depalamarchuk/GaNFET-ESC/README.md

# GaNFET-ESC
This is my master project. Work in progress.
