depalamarchuk/GaNFET-ESC/Thesis/Very Important App Notes/PRIVATE-Myxadesignnotes-241019-1215-2464 (2).pdf

# Myxa design notes

Phase signal sensing

This document describes main decisions when designing Myxa PMSM controller.

Sections:

MCU
Step-down converter
DRV8302
Power mosfets
Phase current sensing
Phase signal sensing
Input capacitor battery
UAVCAN
USB
AUX input
TVS diode

# MCU

MYXA uses STM32F446 MCU, preferably with operating temperature range -40..+105C. Current boards though have only -40°C ~ 85°C MCU version. This is known issue and a least-evil solution due to the lack of proper MCUs in the world.

MCU is powered by dedicated 3.3V LDO. (https://www.digikey.com/product-detail/en/texas-instruments/TPS73433TDDCRQ1/296-36844-1-ND/4341509)

VDDA is tied to reference voltage source REF3033. (https://www.digikey.com/products/en?keywords=296-26324-1-ND) It may seem weird, but it is capable of providing up to 25mA current, so its ok.

# Step-down converter

Step-down dc-dc converter is tps54160 (https://www.digikey.com/product-detail/en/texas-instruments/TPS54160DGQR/296-26984-2-ND/2047950) embedded in DRV8302 (https://www.digikey.com/product-detail/en/texas-instruments/DRV8302DCA/296-33275-5-ND/2799356)

Inductor SRP6540-220M (https://www.digikey.com/products/en?keywords=SRP6540-220MTR-ND) (FIXED IND 22UH 2.5A 133 MOHM SMD)

Shottky diode: PMEG6020ER,115 (https://www.digikey.com/product-detail/en/nexperia-usa-inc/PMEG6020ER,115/1727-5217-2-ND/2296182) (DIODE SCHOTTKY 60V 2A SOD123W)

Input:

Vin = 8..60V

## Output:

R1 = 10K, R2 = 53,6K

## Operating frequency:

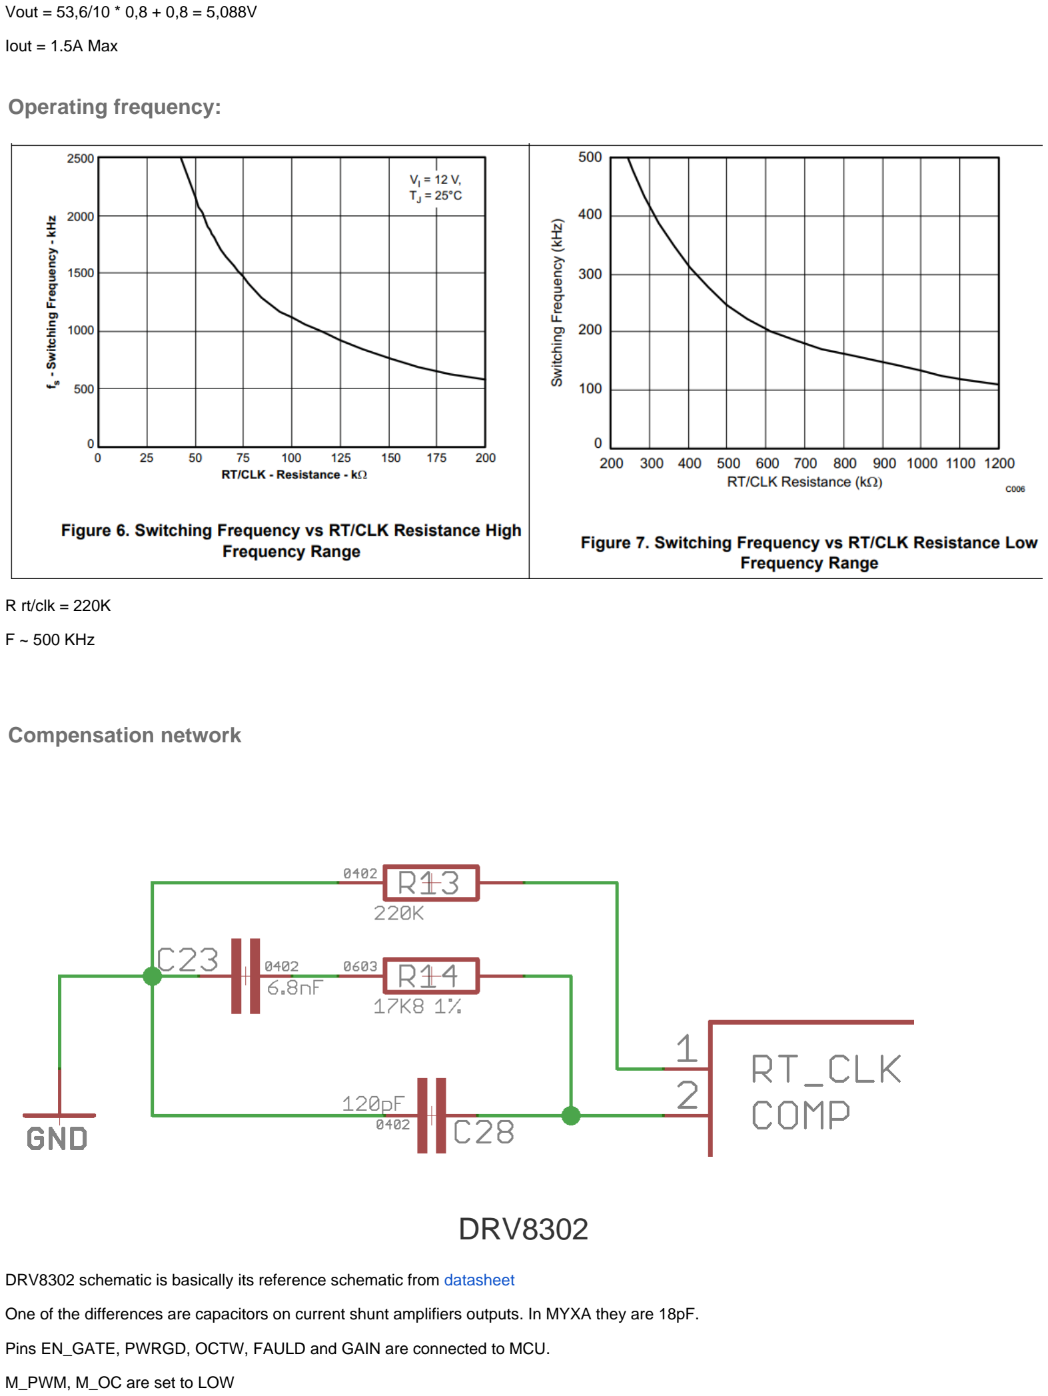
[picture p1: page 2]

Vout = 53,6/10 * 0,8 + 0,8 = 5,088V

Iout = 1.5A Max

R rt/clk = 220K

F ~ 500 KHz

## Compensation network

# DRV8302

DRV8302 schematic is basically its reference schematic from datasheet (http://www.ti.com/lit/ds/symlink/drv8302.pdf)

One of the differences are capacitors on current shunt amplifiers outputs. In MYXA they are 18pF.

Pins EN_GATE, PWRGD, OCTW, FAULD and GAIN are connected to MCU.

M_PWM, M_OC are set to LOW

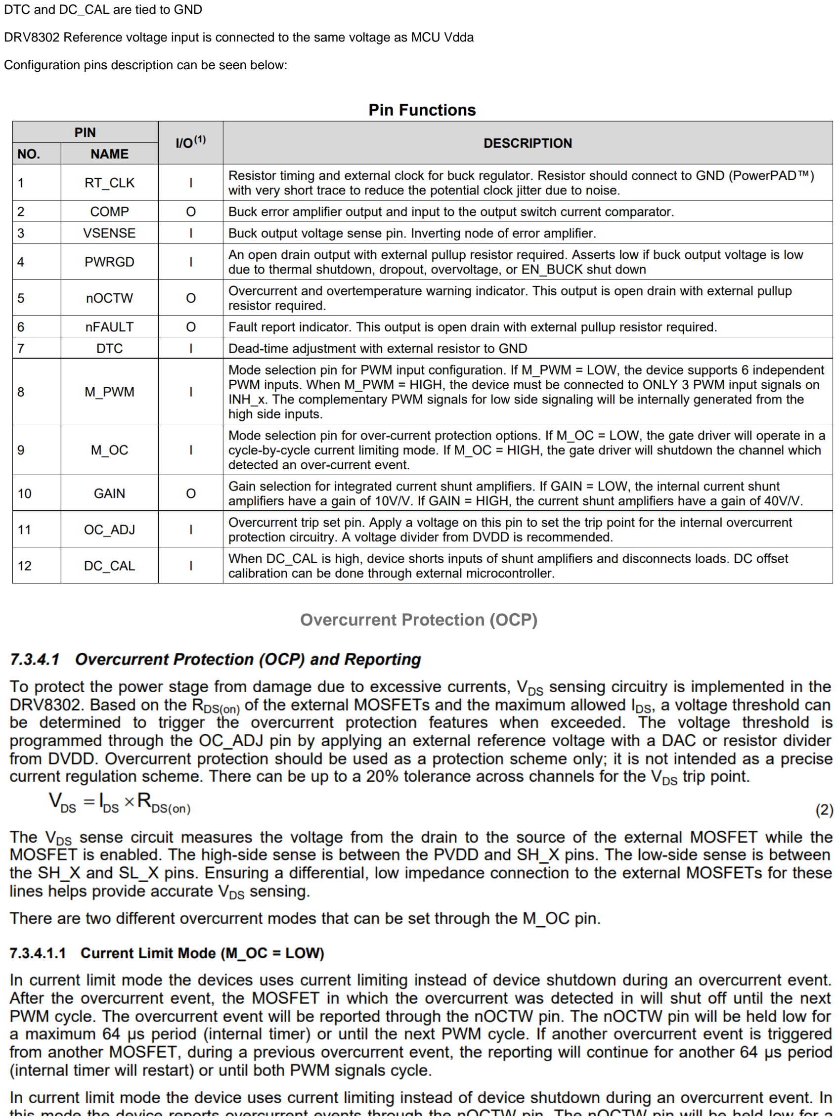
[picture p2: page 3]

DTC and DC_CAL are tied to GND

DRV8302 Reference voltage input is connected to the same voltage as MCU Vdda

Configuration pins description can be seen below:

## Overcurrent Protection (OCP)

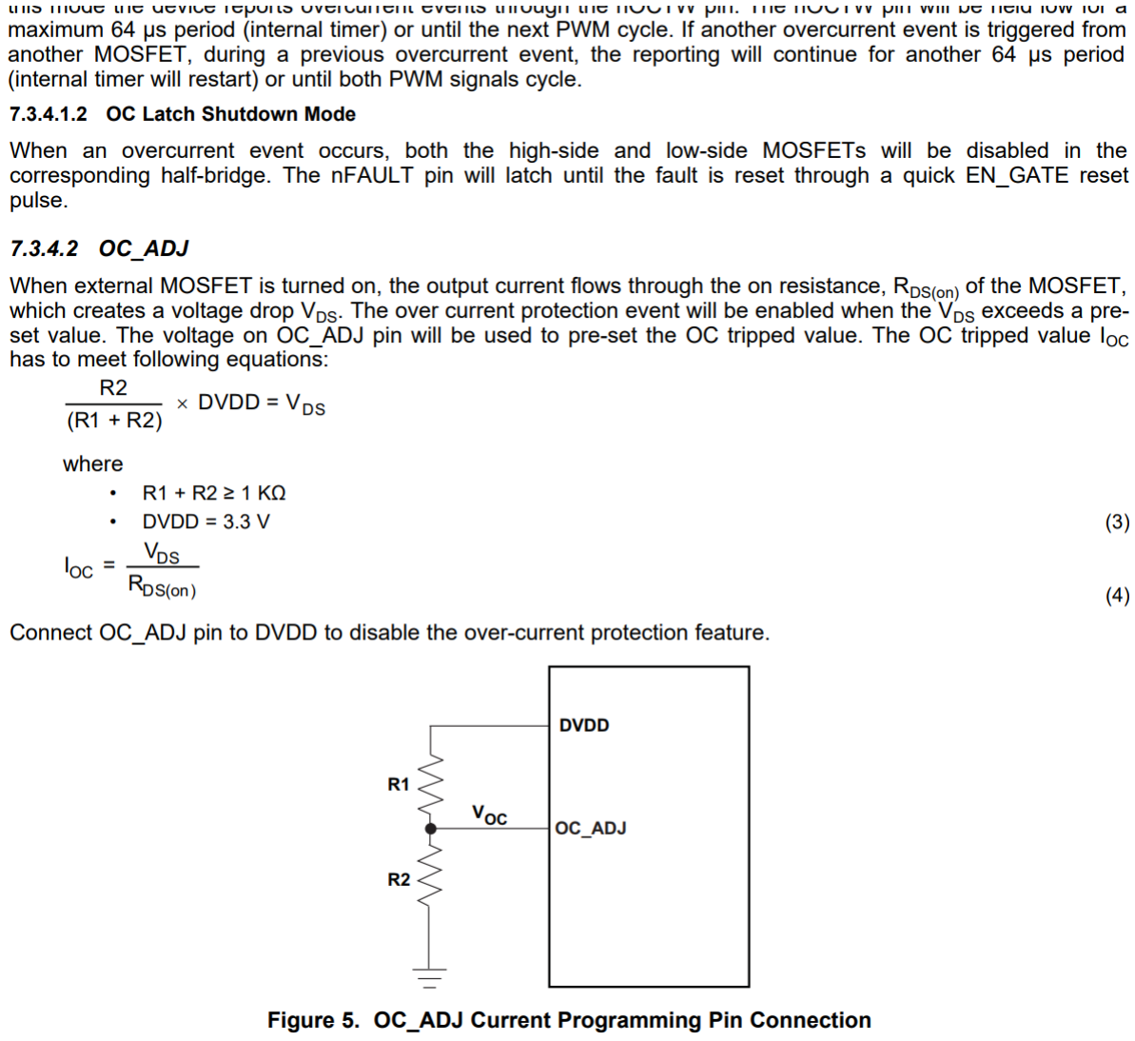
[picture p3: figure]

In current MYXA design

R1 = 10K

R2 = 1.3K

DVDD = 3.3V

Vds = 1.3/(10+1.3) * 3.3 = 0.38

Vds = 0,005 * I,

I trip = 0.38/0,005 = 76A

# Power mosfets

As power keys MYXA uses state of the art mosfets BSC040N08NS5ATMA1 (https://www.digikey.com/product-detail/en/infineon-technologies/BSC040N08NS5ATMA1/BSC040N08NS5ATMA1CT-ND/6559920) (MOSFET N-CH 80V 100A 8TDSON) from Infineon Technologies

Brief description

FET Type | N-Channel
Technology | MOSFET (Metal Oxide)
Drain to Source Voltage (Vdss) | 80V
Current - Continuous Drain (Id) @ 25°C | 100A (Tc)
Drive Voltage (Max Rds On, Min Rds On) | 6V, 10V
Vgs(th) (Max) @ Id | 3.8V @ 67µA
Gate Charge (Qg) (Max) @ Vgs | 54nC @ 10V
Input Capacitance (Ciss) (Max) @ Vds | 3900pF @ 40V
Vgs (Max) | ±20V
FET Feature | -
Power Dissipation (Max) | 2.5W (Ta), 104W (Tc)
Rds On (Max) @ Id, Vgs | 4 mOhm @ 50A, 10V
Operating Temperature | -55°C ~ 150°C (TJ)
Mounting Type | Surface Mount
Supplier Device Package | PG-TDSON-8
Package / Case | 8-PowerTDFN

Each mosfet has 4R3 gate resistor to eliminate gate-ringing

Loss estimation at 12S@30A:

Static loss:

P = (I^2 * R) = 0.004 * 30 * 30 = 3,6 W

Dynamic loss:

P = 1/2 * Vin * Iout * (Trise + Tfall) * Fswitch

According to DRV8302 datasheet (http://www.ti.com/lit/ds/symlink/drv8302.pdf)

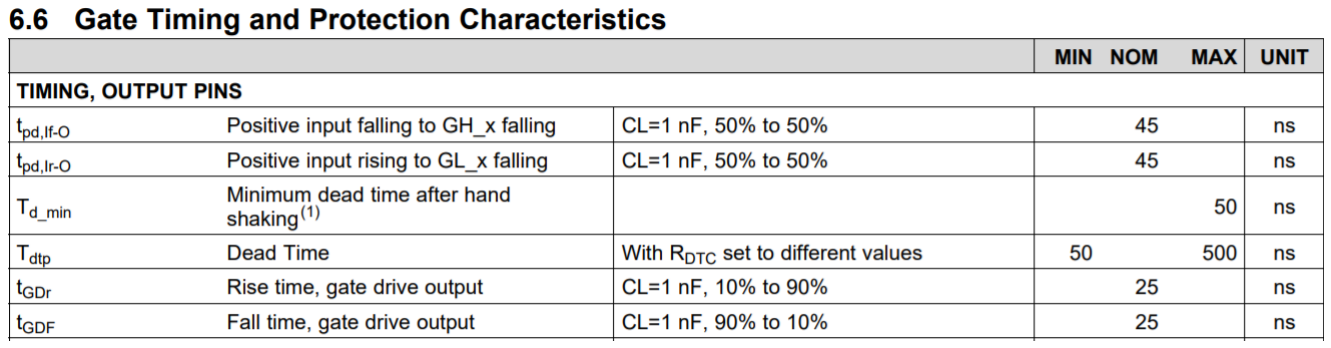
[picture p4: figure]

Trise = Tfall ~ 100 ns

P = 1/2 * 50,4 * 30 * (100 + 100) * 10^-9 * 45 000 ~ 6,8 W

Total loss per switch Ploss_sw ~ 11W

Total loss per phase Ploss_ph ~ 22W

A spreadsheet for calculations above (https://docs.google.com/spreadsheets/d/1axGHQfVU-xP3OTxVYLaaQBSNWgYnpkbbmnyLpejNwkY/edit?usp=sharing)

Also simulation models to find out tRise and tFall times more precisely can be found below. It should be opened with LTSpice

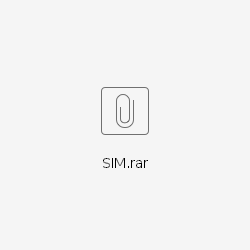
[picture p5: figure]

# Phase current sensing

Current is sensed on two phases using CSNL2512FT3L00(RES (https://www.digikey.com/products/en?keywords=CSNL2512FT3L00CT-ND) SMD 0.003 OHM 1% 2W 2512) current shunts and current sense amplifiers integrated in DRV8302. Each current shunt has 1000pF capacitor connected across it.

Current shunt amplifier gain can be either 10 or 40x depending on GAIN pin of DRV8302 which is controlled by the MCU.

This gives maximum measurable current

I max = 3.3 / (10 * 0.003) = 110A for 10x gain. But max differential voltage of current amplifier is 300mV, so I max = 0,3/0,003 = 100A

I max = 3.3 / (40 * 0.003) = 27.5A for 40x gain

# Phase signal sensing

Instead of more conventional analog voltage reading for phase signal MYXA uses different approach. It monitors signal transition from 0 to 1 on MCU pin, where phase signal is connected to. For that purpose resistor divider for each phase signal is implemented. One of them can be seen below:

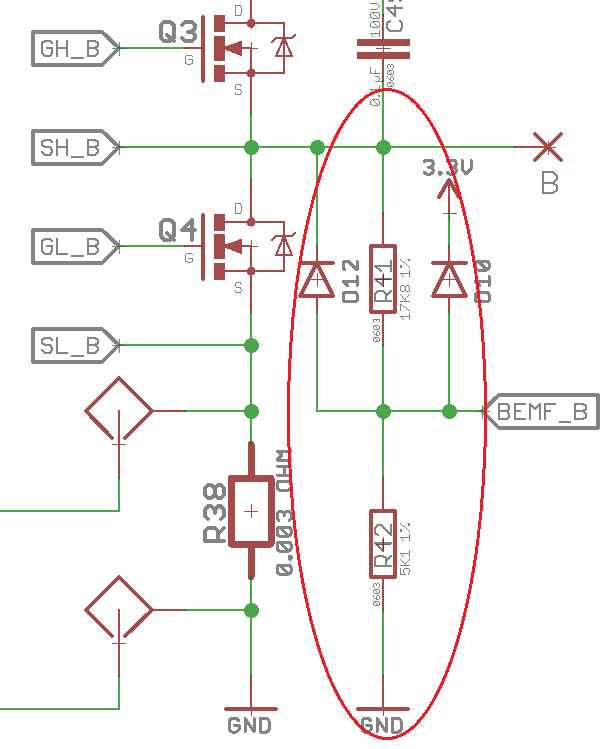
[picture p6: figure]

In order for phase event to be detected BEMF_B voltage must exceed 0.7 * Vdd = 0.7 * 3.3 = 2,31V(according to table below)

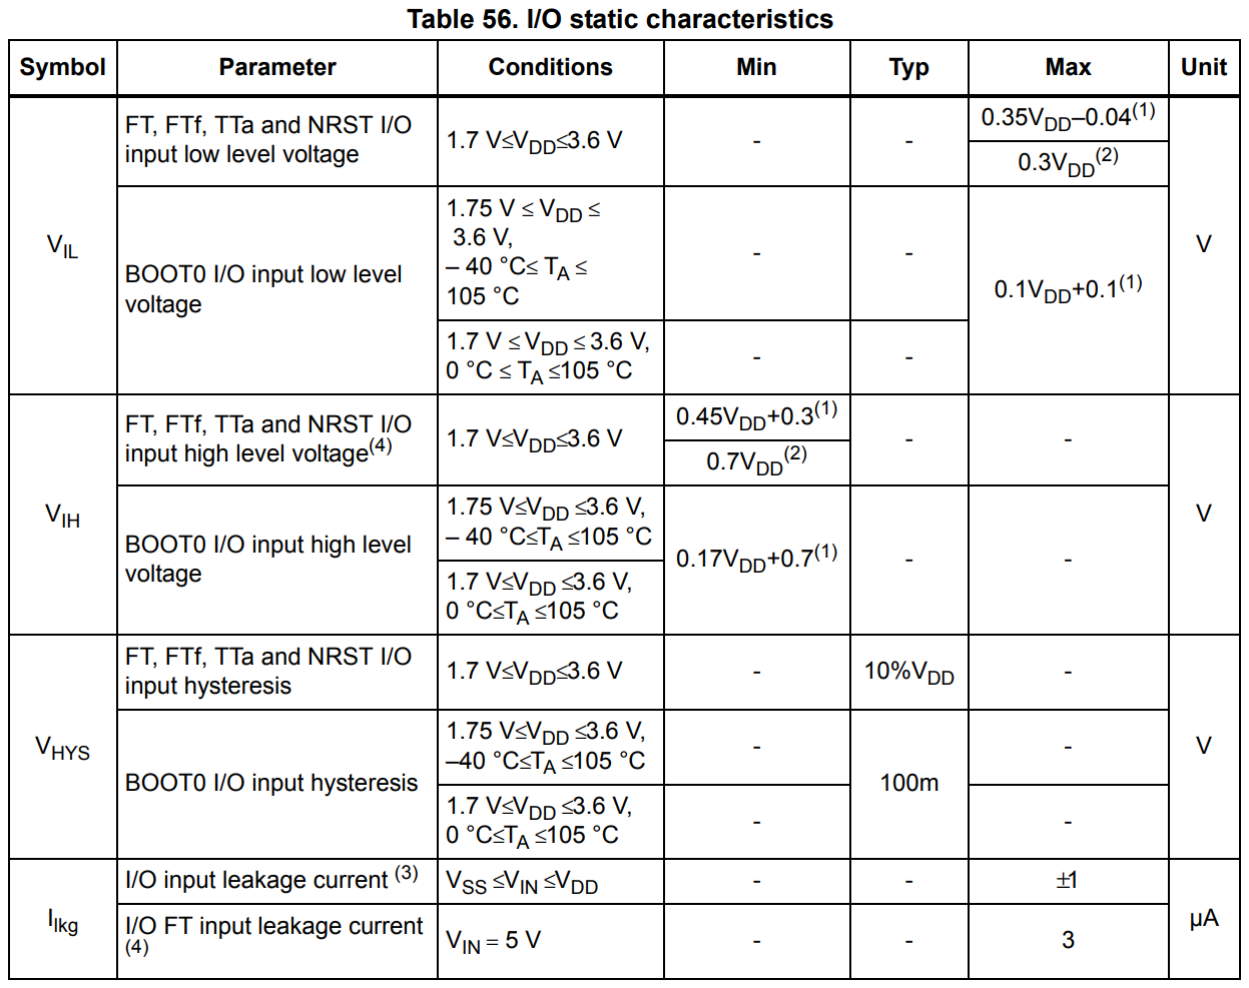
[picture p7: figure]

So, with resistor divider of 17K8 and 5K1 this will happen when phase B voltage will be

3,3 * 0,7 / (5,1/17,8 + 5,1) ~ 10,3 V

# Input capacitor battery

Main input capacitor is 820uF 80V aluminum cap, (https://www.digikey.com/products/en?keywords=EKZN800ELL821MM25S) which is placed as near to power mosfets as possible. Also at least two low-esr 4.7UF 100V (https://www.digikey.com/product-detail/en/tdk-corporation/C3225X7S2A475M200AB/445-6043-1-ND/2444084) ca ps are added per phase.

# UAVCAN

MYXA has two UAVCAN interfaces. MYXA can provide UAVCAN with 5V power source through controllable Current Switch Regulator TPD3S014 DBVR, (https://www.digikey.com/product-detail/en/texas-instruments/TPD3S014DBVR/296-38835-1-ND/5138398) which can also act as e-fuse limiting UAVCAN current to 500mA

Both UAVCAN interfaces use TJA1051TK/3,118 (https://www.digikey.com/product-detail/en/nxp-usa-inc/TJA1051TK-3,118/568-8686-2-ND/2677682) (IC TXRX CAN HIGH SPEED 8HVSON) driver chips, which are supplied with 5V line and IO line is connected to 3.3V.

# USB

USB consists of only one microUSB connector (https://www.digikey.com/products/en?keywords=609-4613-1-ND) and miniature USB-specific TVS-diode array (https://www.digikey.com/product-detail/en/nexperia-usa-inc/PRTR5V0U2F,115/1727-4161-2-ND/1992982)

MYXA can be powered via USB(obviously without powerstage), as USB Vdd is connected to 5V line with CRS08 (https://www.digikey.com/products/en?keywords=CRS08QMCT-ND) Shottky diode

There are also footprints for serial resistors for D+ and D- lines in case some more protection needed. As for now they are replaced with 0 ohm resistors.

# AUX input

MYXA has two AUX inputs which are routed to UAVCAN-like 4-pin (https://www.digikey.com/products/en?keywords=455-1566-1-ND) connector. This connector can provide 5V power to external circuitry as well. 5V AUX line current consumption is limited with resettable fuse (https://www.digikey.com/products/en?keywords=507-1786-1-ND) (PTC RESTTBLE 0.50A 16V CHIP 1210) and one of UAVCAN Current Switch Regulators.

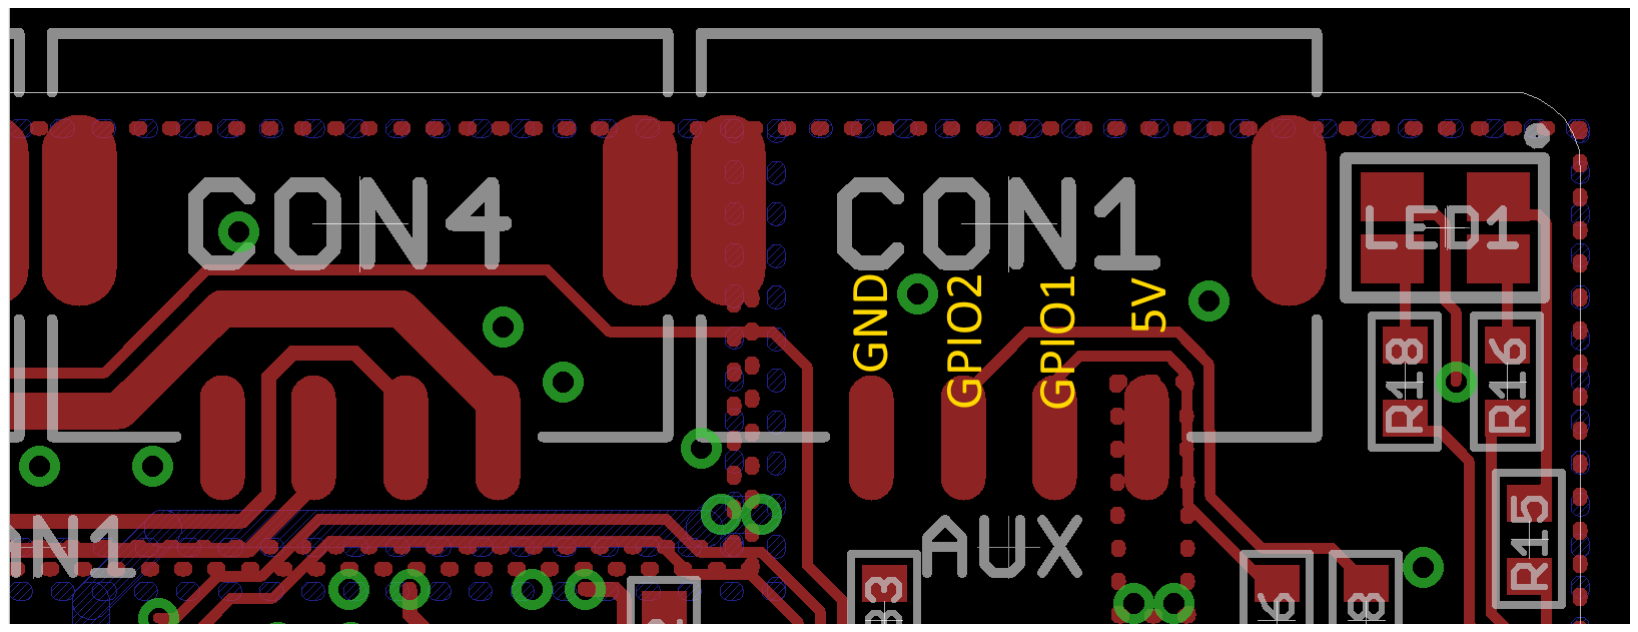
[picture p8: figure]

Both AUX inputs are protected with diode half-bridge (https://www.digikey.com/product-detail/en/diodes-incorporated/BAV99DW-7-F/BAV99DW-FDITR-ND/717716)

GPIO2 is routed directly to the output connector and can be found on pin PA4(ADC3_IN4) of MCU.

GPIO1 is routed to PA3(ADC3_IN3) pin of MCU and also to PB14 pin(where TIM12_CH1 can be found). It is also connected to PC4 with 1K series resistor, so it can be used to connect NTC or PTC thermistor with typical resistance of about 1K(like this one). (https://www.digikey.com/product-detail/en/epcos-tdk/B57164K0102J000/495-75312-ND/3500220) The thermistor should be connected between GND and GPIO1 pins of the AUX connector. Then PC5 should activate PULL-UP to 3.3V and form a resistor divider with 1K resistor(between 3.3v and measured voltage) and thermistor(between measured voltage and gnd) and GPIO1(ADC3_IN3) may be measured.

Also digital 1wire thermometers(like ds18b20) (https://www.digikey.com/product-detail/en/maxim-integrated/DS18B20/DS18B20-ND/420071) may be used on GPIO1 using PWM generation on TIM12_CH1 and DMA to guarantee proper 1-wire timings. This may come handy in extremely noisy environments when analog readings on long thermistor wires are corrupted

# TVS diode

Although by default Myxa is shipped without TVS diode installed, there may be some situations that require it installed. In that case user can install it by himself on the provided footprint. The best choice is SMBJ54A (https://www.digikey.com/products/en?keywords=SMBJ54ALFTR-ND) from Littlefuse although any other TVS diode in DO214AA package and with breakdown voltage no more than 60V will fit.

The footprint for the diode is shown on the picture below

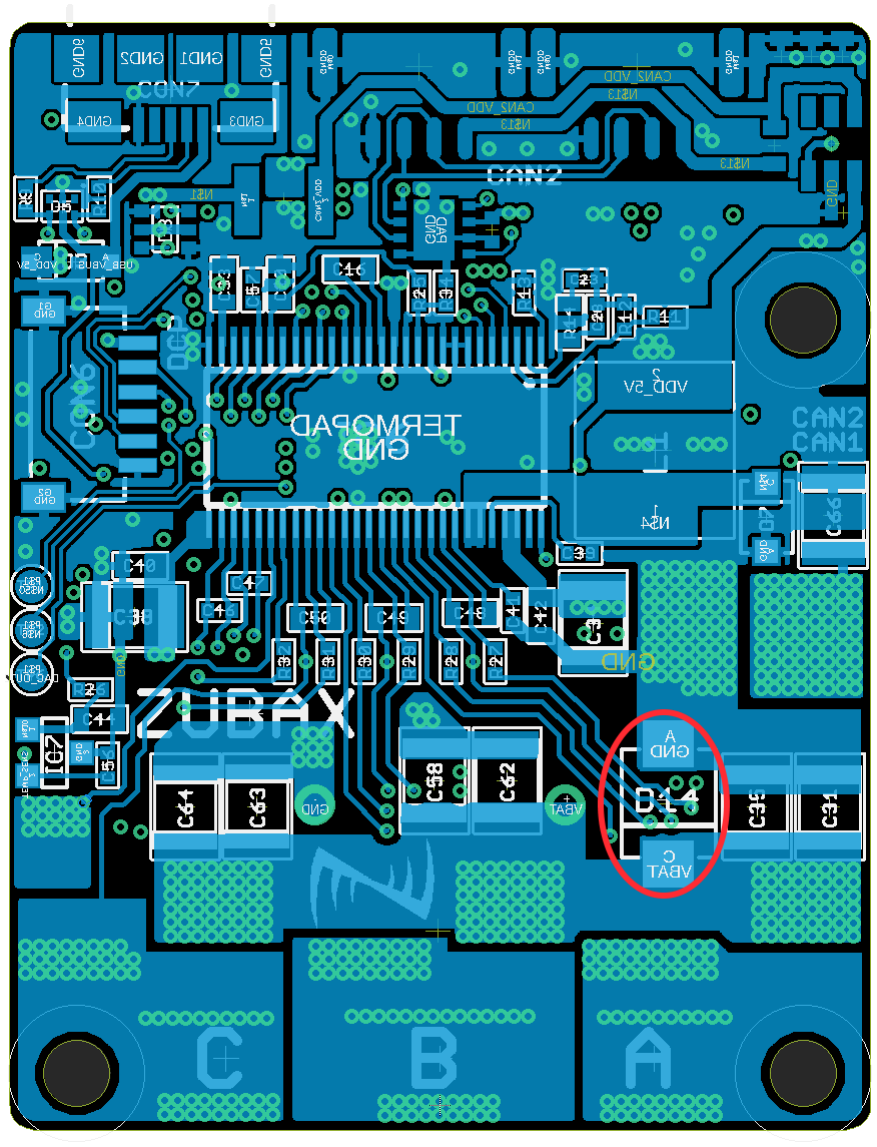
[picture p9: figure]
