depalamarchuk/GaNFET-ESC/ESC_hardware/GaN_Fet_ESC/V0.2/GaN_Fet_ESC_V0.2_BOM/GaN_Fet_ESC_V0.2_BOM.xlsx

 |  | GaN Fet Electronic Speed Controller PCB BOM
Qty | Parts | Value | Description | Case | Supplier | Supplier ID | Manufacturer | Manufacturer ID | Alternative manufacturers. 1 – All 2 – First ask 3 – do not replace
2 | C78, C79 | 18pF C0G 5% | ±5% ≥6.3V Ceramic Capacitor C0G/NP0 | C0402 | Mouser | 80-C0402C180J8G | KEMET | C0402C180J8GACTU | 1
1 | C29 | 47pF C0G 5% | ±5% ≥10V Ceramic Capacitor C0G/NP0 | C0402 | Mouser | 80-C0402C470J5G | KEMET | C0402C470J5GACTU | 1
1 | C54 | 100pF C0G 5% | ±5% ≥6.3V Ceramic Capacitor C0G/NP0 | C0402 | Mouser | 80-C0402C101J5G7411 | KEMET | C0402C101J5GAC7411 | 1
8 | C25, C33, C61, C66, C71, C80, C82, C83 | 10nF 10V | ±10% ≥10V Ceramic Capacitor X7R | C0402 | Mouser | 80-C0402C103K3R | KEMET | C0402C103K3RACTU | 1
23 | C35, C42, C43, C44, C45, C48, C49, C53, C55, C58, C60, C63, C65, C68, C70, C73, C75, C77, C81, C84, C85, C86, C88 | 0.1uF 10V | ±10% ≥10V Ceramic Capacitor X7R | C0402 | Mouser | 81-GRM155R71H104KE4D | Murata Electronics | GRM155R71H104KE14D | 1
11 | C27, C28, C32, C37, C39, C41, C57, C62, C67, C74, C76 | 1uF 10V | ±10% ≥10V Ceramic Capacitor X7S | C0402 | Mouser | 81-GCM155C71A105KE8D | Murata Electronics | GCM155C71A105KE38D | 1
16 | C26, C34, C36, C38, C40, C46, C47, C50, C51, C52, C56, C59, C64, C69, C72, C87 | 10uF 10V | ±10% ≥10V Ceramic Capacitor X7T | C0603 | Mouser | 81-GRM188D71A106KA3 | Murata Electronics | GRM188D71A106KA73D | 1
21 | C4, C5, C6, C7, C8, C9, C10, C11, C12, C13, C14, C15, C16, C17, C18, C19, C20, C21, C22, C23, C24 | 4.7uF 100V | ±10% ≥100V Ceramic Capacitor X7S | C1210 | Mouser | 963-HMK325C7475KM-PE | Taiyo Yuden | HMK325C7475KM-PE | 1
2 | C30, C31 | 47uF 10V | ±10% ≥10V Ceramic Capacitor X5R | C1206 | Mouser | 81-GRM31CR61A476KE5L | Murata Electronics | GRM31CR61A476KE15L | 1
3 | C1, C2, C3 | 680uF 80V | 680µF 80V Aluminum Electrolytic Capacitors Radial, Can 10000 Hrs @ 105°C | C_7.50_16_26.5 | Mouser | 661-EKZN800E681ML25S | United Chemi-Con | EKZN800ELL681ML25S | 2
6 | R17, R18, R23, R24, R29, R30 | 0R | ±5% 100 mW 50V Chip Resistor 0402 | R0402 | Mouser | 660-RK73Z1ETTP | KOA Speer | RK73Z1ETTP | 1
2 | R2, R3 | 0R | ±5% 100 mW 50V Chip Resistor 0402 | R0603 | Mouser | 667-ERJ-U030R00V | Panasonic | ERJ-U030R00V | 1
3 | R19, R25, R31 | 0.75m 1% | Current Sense Resistors - SMD 3W 0.0007 Ohm 1% | CSS2H-2512 | Mouser | 756-LRMAP25R00075FT4 | Welwyn Components / TT Electronics | LRMAP2512-R00075FT4 | 1
6 | R44, R45, R46, R48, R49, R50 | 10R 5% | ±5% 62.5 mW 50V Chip Resistor 0402 | R0402 | Mouser | 603-RC0402JR-0710RL | YAGEO | RC0402JR-0710RL | 1
1 | R47 | 120R 0.25W 1% | ±1% 250 mW Chip Resistor 0805 | R0805 | Mouser | 667-ERJ-P06F1200V | Panasonic | ERJ-P06F1200V | 1
3 | R37, R39, R41 | 180R 5% | ±5% 62.5 mW 50V Chip Resistor 0402 | R0402 | Mouser | 667-ERJ-2RKF1800X | Panasonic | ERJ-2RKF1800X | 1
5 | R11, R12, R35, R55, R56 | 1k 5% | ±5% 62.5 mW 50V Chip Resistor 0402 | R0402 | Mouser | 603-AC0402JR-071KL | YAGEO | AC0402JR-071KL | 1
9 | R9, R14, R22, R28, R34, R40, R53, R54, R57 | 3.3k 5% | ±5% 62.5 mW 50V Chip Resistor 0402 | R0402 | Mouser | 603-AC0402JR-073K3L | YAGEO | AC0402JR-073K3L | 1
1 | R42 | 10k 0.5% | ±0.5% 25ppm 62.5 mW 50V Chip Resistor 0603 | R0603 | Mouser | 279-CPF0603D10KE | TE Connectivity / Holsworthy | CPF0603D10KE | 1
8 | R8, R10, R13, R16, R36, R38, R51, R52 | 10k 1% | ±1% 62.5 mW 50V Chip Resistor 0402 | R0402 | Mouser | 603-RC0402FR-0710KP | YAGEO | RC0402FR-0710KP | 1
3 | R20, R26, R32 | 10k 0.5W 75V 5% | ±5% 500 mW Chip Resistor 0805 | R0805 | Mouser | 667-ERJ-P06J103V | Panasonic | ERJ-P06J103V | 1
1 | R43 | 33k 0.5% | ±0.5% 25ppm 62.5 mW 50V Chip Resistor 0603 | R0603 | Mouser | 667-ERA-3AED333V | Panasonic | ERA-3AED333V | 1
1 | R15 | 174k 75V 1% | ±1% 62.5 mW 50V Chip Resistor 0603 | R0603 | Mouser | 603-AC0603FR-07174KL | YAGEO | AC0603FR-07174KL | 1
1 | R7 | 249k 1% | ±1% 62.5 mW 50V Chip Resistor 0402, AEC-Q200 | R0402 | Mouser | 660-RK73H1ETTP2493F | KOA Speer | RK73H1ETTP2493F | 1
1 | R6 | 1M 1% | ±1% 62.5 mW 50V Chip Resistor 0402, AEC-Q200 | R0402 | Mouser | 660-RK73H1ETTP1004F | KOA Speer | RK73H1ETTP1004F | 1
1 | L1 | 120R | Ferrite Beads 1206 120ohms ≥3A | L1206 | Mouser | 81-BLM31KN121SZ1L | Murata Electronics | BLM31KN121SZ1L | 1
10 | L3, L4, L5, L6, L7, L8, L9, L10, L11, L12 | 470R | Ferrite Beads 0603 470ohms | L0603 | Mouser | 81-BLM18KG471SN1D | Murata Electronics | BLM18KG471SN1D | 1
1 | L2 | 15uH 2.75A | Fixed Inductors WE-LHMI Powr SMD7050 15uH 2.75A 92mOhm | WURTH_6.6X6.6 | Mouser | 710-74437349150 | Wurth Elektronik | 74437349150 | 3
1 | Y1 | 16Mhz 12pF | Crystals AEC-Q200 16MHz 12pF 3.2x2.5mm | CRYSTAL_SMD_3.2X2.5MM | Mouser | 581-CX3225SB16000HLJ | Kyocera AVX | CX3225SB16000H0FLJCC | 1
2 | D1, D21 | SMBJ60A | ESD Suppressors / TVS Diodes 60volts 5uA 6.2 Amps Uni-Dir | DO214AA(SMB) | Mouser | 652-SMBJ60A | Bourns | SMBJ60A | 1
1 | D2 | MM3Z12V | Zener Diodes 12V 200mW | SOD323F | Mouser | 863-MM3Z12VT1G | onsemi | MM3Z12VT1G | 1
5 | D3, D4, D7, D12, D17 | BAS16 | Diodes - General Purpose, Power, Switching SWITCHING DIODE | SOD523 | Mouser | 863-BAS16XV2T5G | onsemi | BAS16XV2T5G | 1
3 | D5, D10, D15 | PMEG10010ELR | Schottky Diodes & Rectifiers 1A Schottky Barrier Rectifier | SOD123F | Mouser | 771-PMEG10010ELRX | Nexperia | PMEG10010ELRX | 1
3 | D8, D13, D18 | BAT54 | Schottky Diodes & Rectifiers 30V 200mW Single | SOD523 | Mouser | 863-BAT54XV2T1G | onsemi | BAT54XV2T1G | 1
1 | D20 | PESD2CAN | ESD Suppressors / TVS Diodes DIODE ESD PROT | SOT23 | Mouser | 771-PESD2CANFD24V-TR | Nexperia | PESD2CANFD24V-TR | 1
1 | D22 | MM3Z3V3 | Zener Diodes 3.3V 200mW | SOD323F | Mouser | 863-MM3Z3V3T1G | onsemi | MM3Z3V3T1G | 1
1 | D23 | PESD3V3U1UA | ESD Suppressors / TVS Diodes DIODE ARRAY ESD 1L ULTRA LO CD | SOD323F | Mouser | 771-PESD3V3U1UA-T/R | Nexperia | PESD3V3U1UA,115 | 1
2 | D24, D25 | PESD5V0L5U | ESD Suppressors / TVS Diodes Diode TVS Quint Uni-Dir 5V 25W 6-Pin | SC-70-6 | Mouser | 771-PESD5V0L5UY,125 | Nexperia | PESD5V0L5UY,125 | 1
4 | LED1, LED2, LED3, LED4 | green | Green 570nm LED Indication - Discrete 2V 0603 (1608 Metric) | CHIP-LED0603 | Mouser | 710-150060VS75000 | Wurth Elektronik | 150060VS75000 | 1
1 | LED5 | yellow | Yellow 589nm LED Indication - Discrete 2V 0603 (1608 Metric) | CHIP-LED0603 | Mouser | 710-150060YS75000 | Wurth Elektronik | 150060YS75000 | 1
1 | LED6 | white | Standard LEDs - SMD White Clear Non-Diff | CHIP-LED0603 | Mouser | 78-VLMW1300-GS08 | Vishay Semiconductors | VLMW1300-GS08 | 1
1 | LED7 | blue | Blue 470nm LED Indication - Discrete 3.2V 0603 (1608 Metric) | CHIP-LED0603 | Mouser | 710-150060BS75000 | Wurth Elektronik | 150060BS75000 | 1
1 | LED8 | red | Red 625nm LED Indication - Discrete 2V 0603 (1608 Metric) | CHIP-LED0603 | Mouser | 710-150060RS75000 | Wurth Elektronik | 150060RS75000 | 1
1 | Q1 | BCM53DS | Bipolar Transistors - BJT BCM53DS SC-74 | SC-74 | Mouser | 771-BCM53DSX | Nexperia | BCM53DSX | 2
2 | Q2, Q10 | MMBT5550L | Bipolar Transistors - BJT SS HV XSTR NPN 160V | SOT23 | Mouser | 863-MMBT5550LT1G | onsemi | MMBT5550LT1G | 1
1 | Q3 | SI2337DS-T1-BE3 | MOSFET P-CHANNEL 80-V (D-S) | SOT23C | Mouser | SI2337DS-T1-BE3 | Vishay / Siliconix | SI2337DS-T1-BE3 | 1
6 | Q4, Q5, Q6, Q7, Q8, Q9 | EPC2206 | GaN FET, eGaN®, Vds = 80V, Rds(on) = 2.2 mOhm, Id = 90 A, Qgd = 3 nC, Qrr = 0 nC, Qg = 15 nC | EPC2206 | Digi-Key | 917-1212-1-ND | EPC | EPC2206 | 2
1 | U1 | LM46002 | 3.5-V to 60-V, 2-A Synchronous Step-Down Voltage Converter | TSS0P16-PAD | Mouser | 595-LM46002PWPR | Texas Instruments | LM46002PWPR | 3
1 | U2 | LP2985-3.3 | LP2985 150-mA Low-noise Low-dropout Regulator With Shutdown | SOT-23-5 | Mouser | 595-LP2985-33DBVR | Texas Instruments | LP2985-33DBVR | 2
3 | U3, U4, U5 | LMG1205 | LMG120580-V, 1.2-A to 5-A, Half Bridge GaN Driver with Integrated Bootstrap Diode | LMG1205 | Mouser | 595-LMG1205YFXR | Texas Instruments | LMG1205YFXR | 3
1 | U6 | MCP9700A | Temperature Sensor Analog, Local -40°C ~ 125°C 10mV/°C SC-70-5 | SC-70-5 | Mouser | 579-MCP9700AT-E/LT | Microchip Technology | MCP9700AT-E/LT | 3
1 | U7 | ADP3338AKCZ-3.3 | High Accuracy, Ultralow IQ, 1 A, anyCAP® Low Dropout Regulator | SOT223 | Mouser | 584-ADP3338AKCZ3.3R | Analog Devices | ADP3338AKCZ-3.3-RL | 3
1 | U8 | TL1431ACL3T | Adjustable voltage reference | SOT23 | Mouser | 511-TL1431ACL3T | STMicroelectronics | TL1431ACL3T | 2
3 | U9, U10, U11 | INA240A2 | INA240 High- and Low-Side, Bidirectional, Zero-Drift, Current-Sense Amplifier With Enhanced PWM Rejection | SOIC-8 | Mouser | 595-INA240A2DR | Texas Instruments | INA240A2DR | 3
1 | U12 | SN65HVD232 | SN65HVD23x 3.3-V CAN Bus Transceivers | SOIC-8 | Mouser | 595-SN65HVD232D | Texas Instruments | SN65HVD232D | 2
1 | U13 | STM32G473CET6 | ARM® Cortex®-M4 STM32G4 Microcontroller IC 32-Bit 170MHz 512KB (512K x 8) FLASH 48-LQFP (7x7) | LQFP-48 | Mouser | 511-STM32G473CET6 | STMicroelectronics | STM32G473CET6 | 3
2 | SB1, SB2 | EVQQ2U03W | 6 mm Square Thin Type SMD Light Touch Switches | EVQQ2U03W | Mouser | 667-EVQ-Q2U03W | Panasonic | EVQ-Q2U03W | 3
1 | J1 | AMASS_XT60PW-M | Socket; DC supply; XT60; male; PIN: 2; on PCBs; THT; Colour: yellow | AMASS_XT60PW-M | TME | XT60PW-M | Amass | XT60PW-M | 3
3 | J2, J3, J4 | POLYMAX_3.5MM/TH | PolyMax 3.5mm Gold Connectors 10 PAIRS | POLYMAX_3.5MM | Hobbyking | AM1001A | Amass | AM1001A | 3
1 | J5 | HARWIN_M80-5000442 | Headers & Wire Housings 4P DIL VRT PCTAIL DR JKSCR DATAMTE GD/TI | HARWIN_M80-5000442 | Mouser | 855-M80-5000442 | Harwin | M80-5000442 | 3
1 | J6 | SAMTEC_FTSH-107-01-L-DV-K | Headers & Wire Housings High Reliability Header Strips, 0.050 pitch | SAMTEC_FTSH-107-01-L-DV-K | Mouser | 200-FTSH10701LDVK | Samtec | FTSH-107-01-L-DV-K | 3
6 | D6, D9, D11, D14, D16, D19 | N/A |  | R0603
5 | R4, R5, R21, R27, R33 | N/A |  | R0402
1 | R1 | N/A |  | SOD523
