depalamarchuk/GaNFET-ESC/ESC_hardware/GaN_Fet_ESC/V0.2/GaN_Fet_ESC_V0.2_PCB/GaN_Fet_ESC_V0.2.pdf

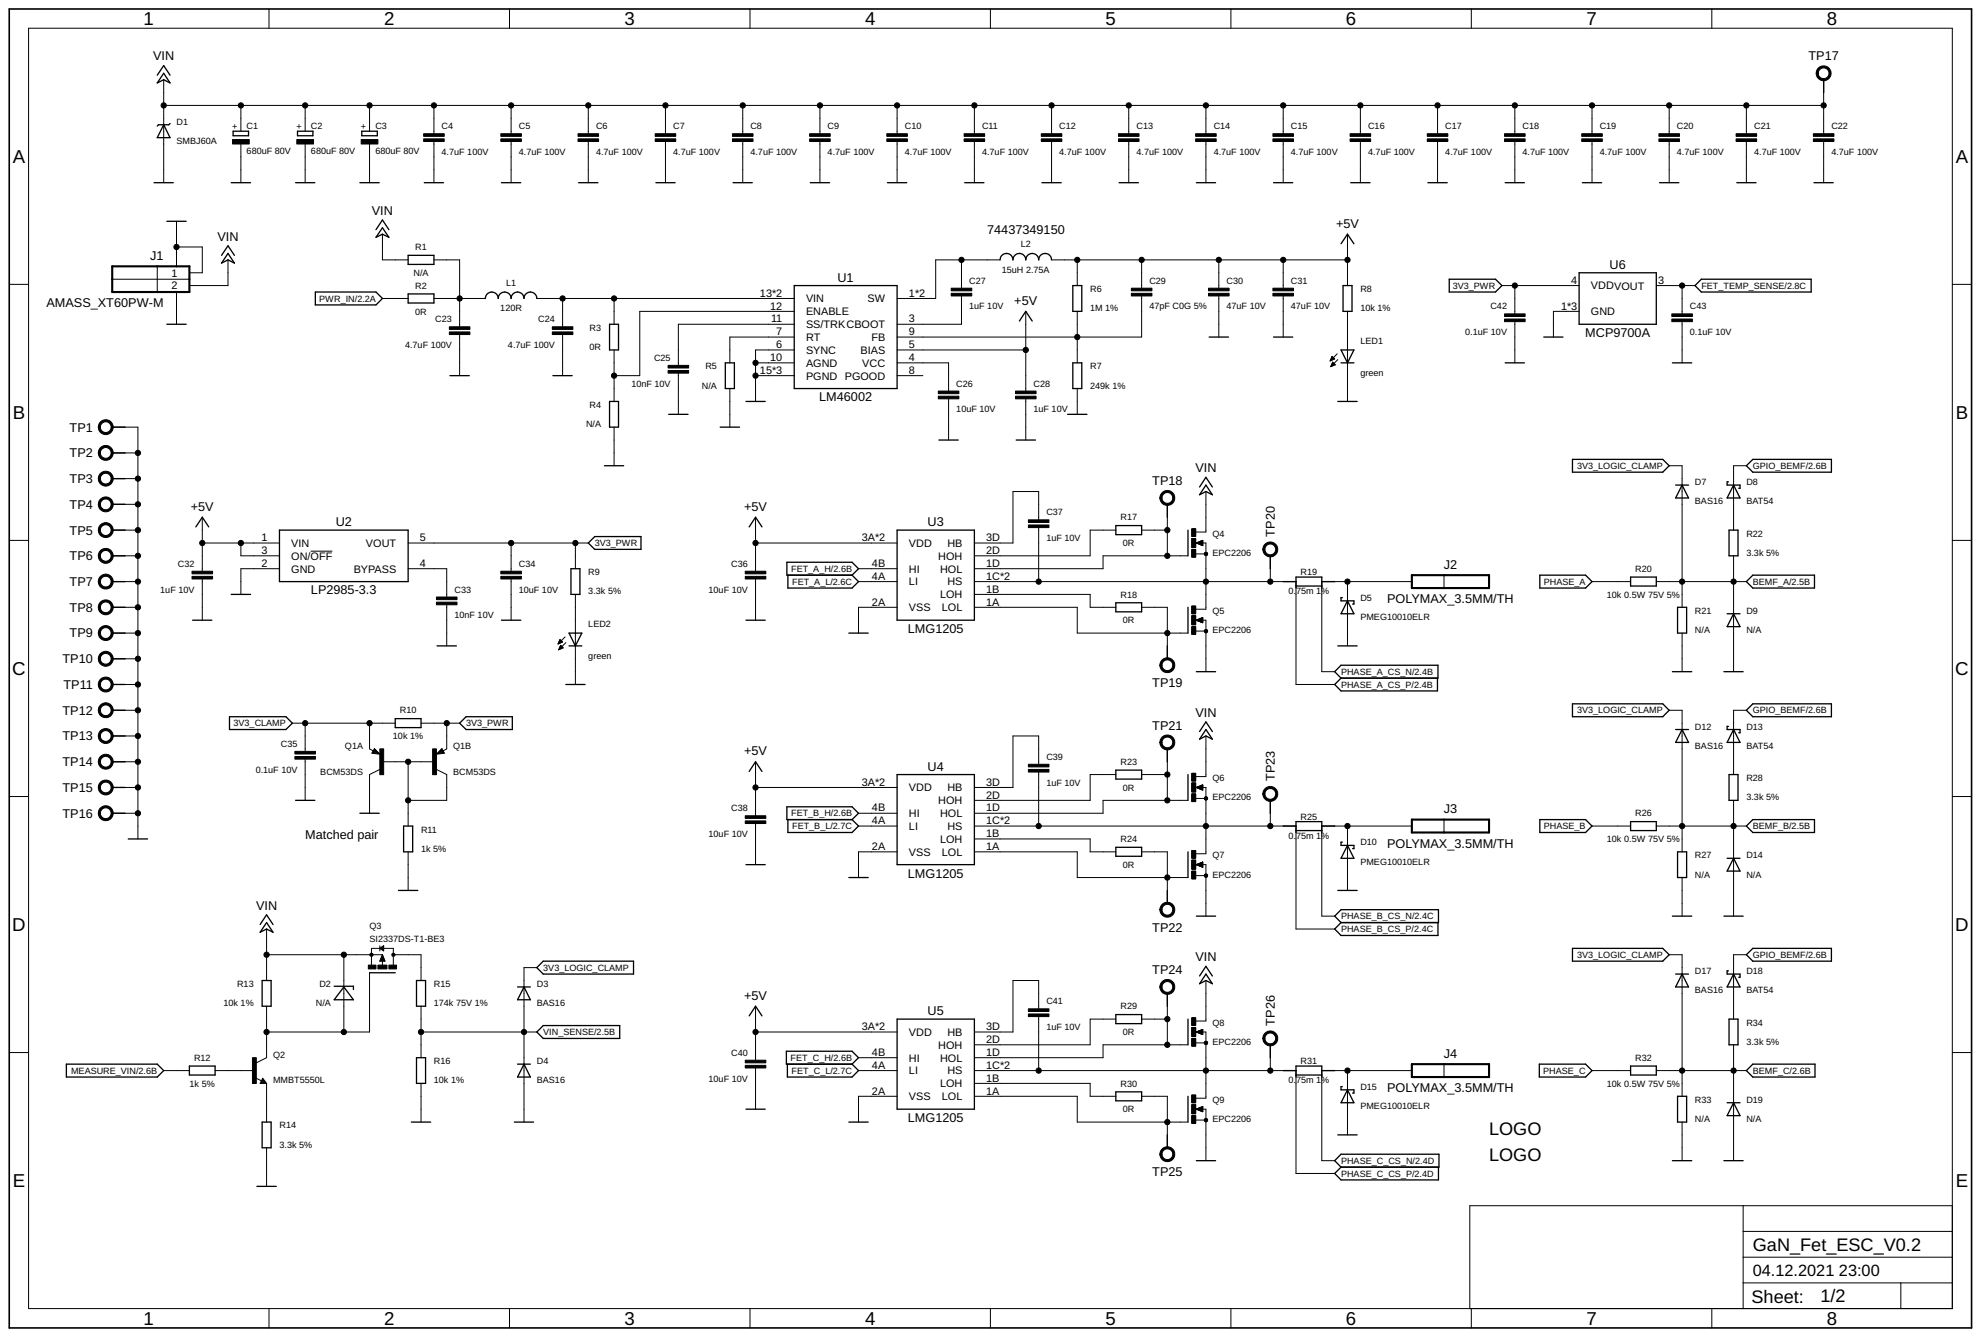
[picture p10: page 1]

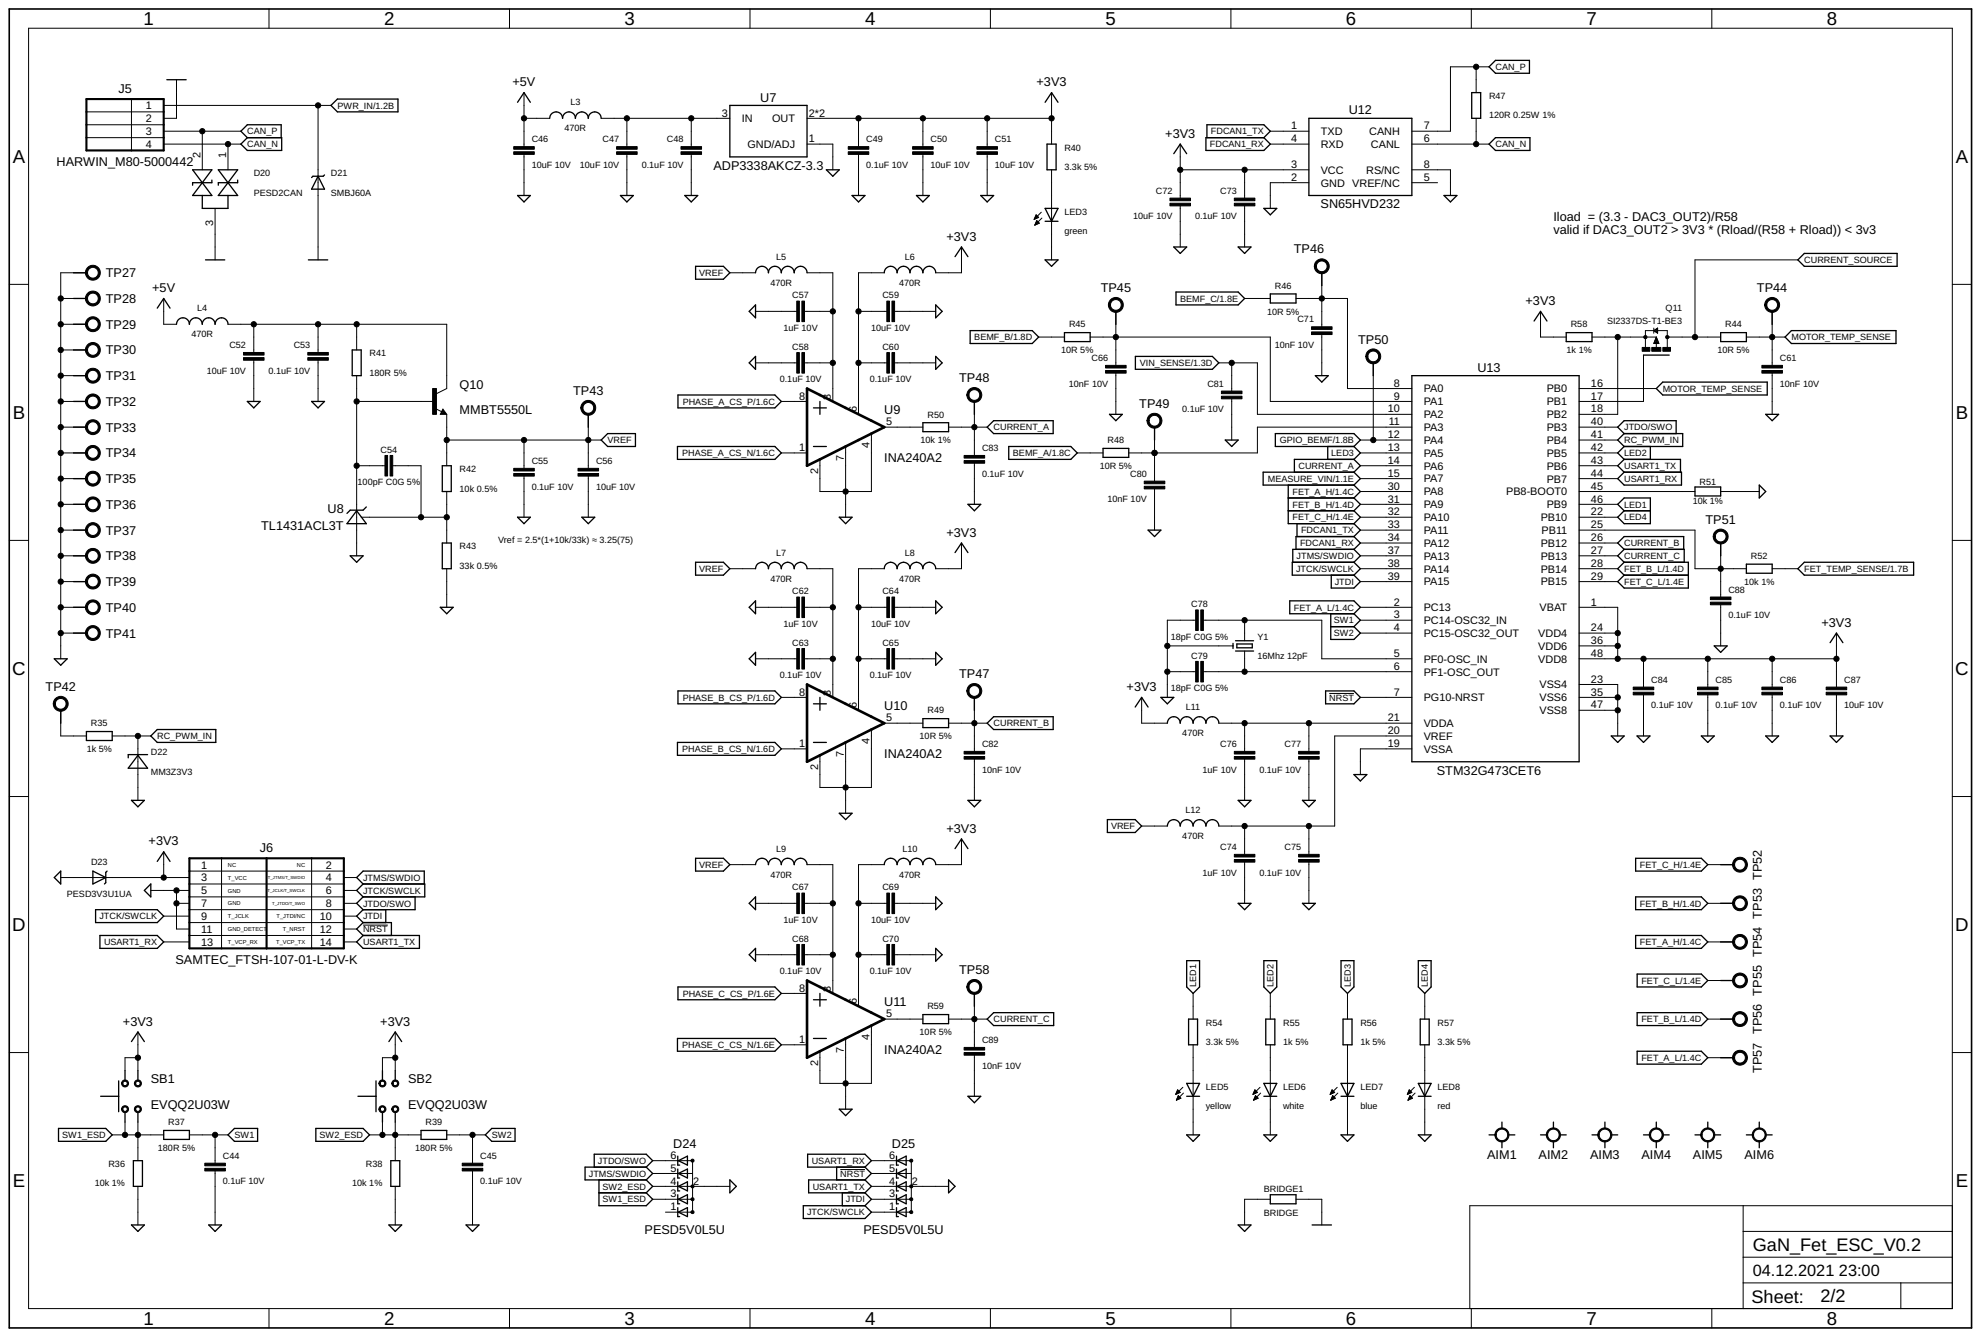
[picture p11: page 2]

Iload = (3.3 - DAC3_OUT2)/R58
valid if DAC3_OUT2 > 3V3 * (Rload/(R58 + Rload)) < 3v3

9 | 17
10 | 18

3 | T_VCC | T_JTMS/T_SWDIO | 4 | JTMS/SWDIO

5 | GND | | 6 | JTCK/SWCLK
7 | | T_JCLK/T_SWCLK GND T_JTDO/T_SWO T_VCP_RX T_VCP_TX | 8 | JTDO/SWO

9 | T_JCLK | T_JTDI/NC | 10 | JTDI

11 | GND_DETECT | T_NRST | 12 | NRST
13 | | | 14 | USART1_TX
