depalamarchuk/GaNFET-ESC/ESC_hardware/GaN_Fet_ESC/V0.1/GaN_Fet_ESC_V0.1_PCB/GaN_Fet_ESC_V0.1.pdf

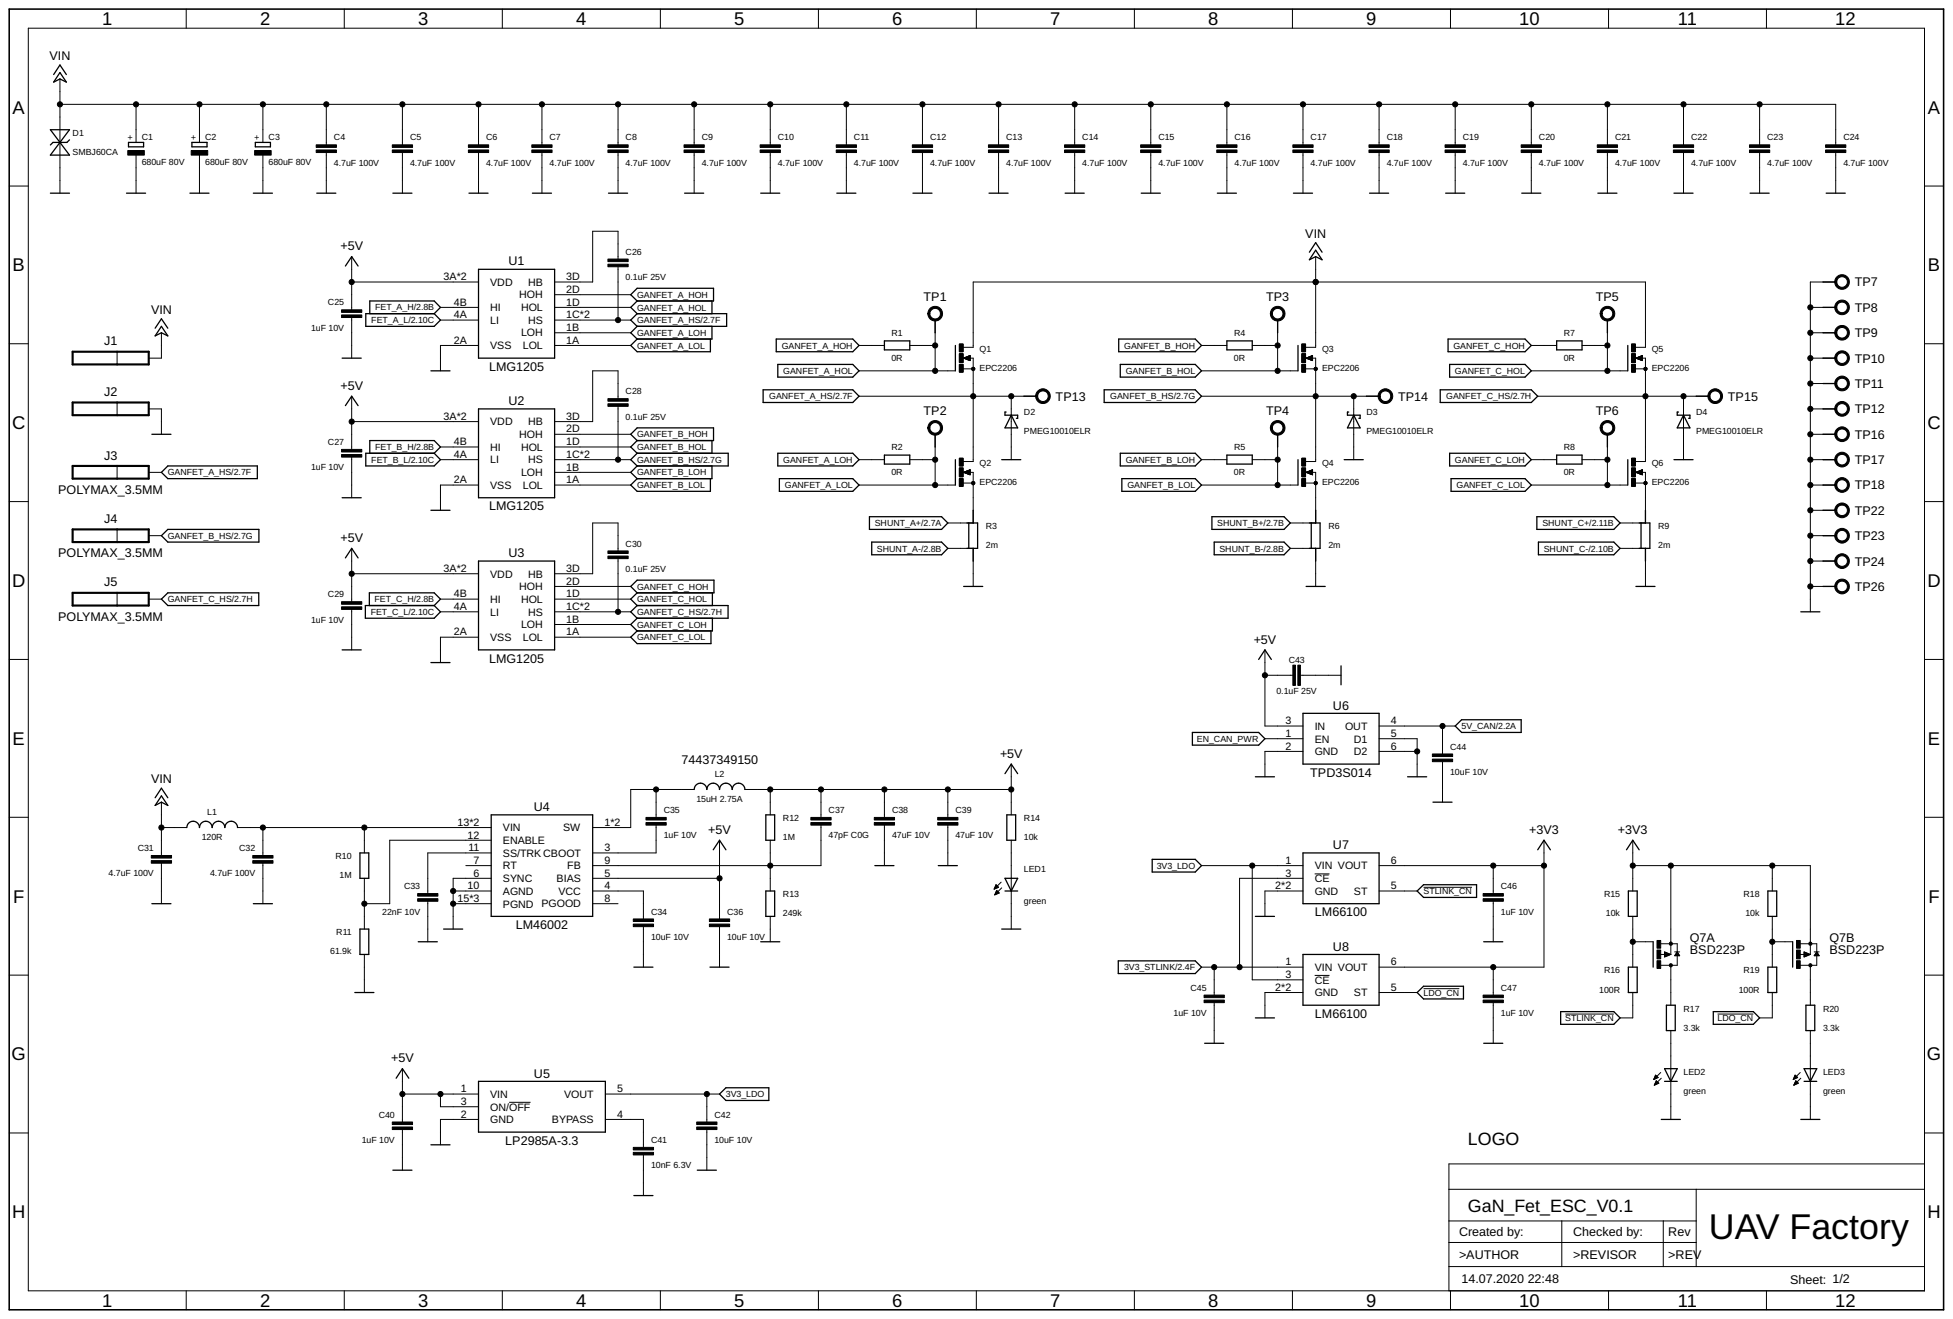
[picture p12: page 1]

FET_A_L/2.10C 2A

FET_A_H/2.8B | | 1D

1D | GANFET_C_HOH

FET_C_L/2.10C 2A | GANFET_C_HS/2.7H 1B

GaN_Fet_ESC_V0.1 | UAV Factory
Checked by: | Rev | Sheet: Created by:

>AUTHOR | >REVISOR | >REV

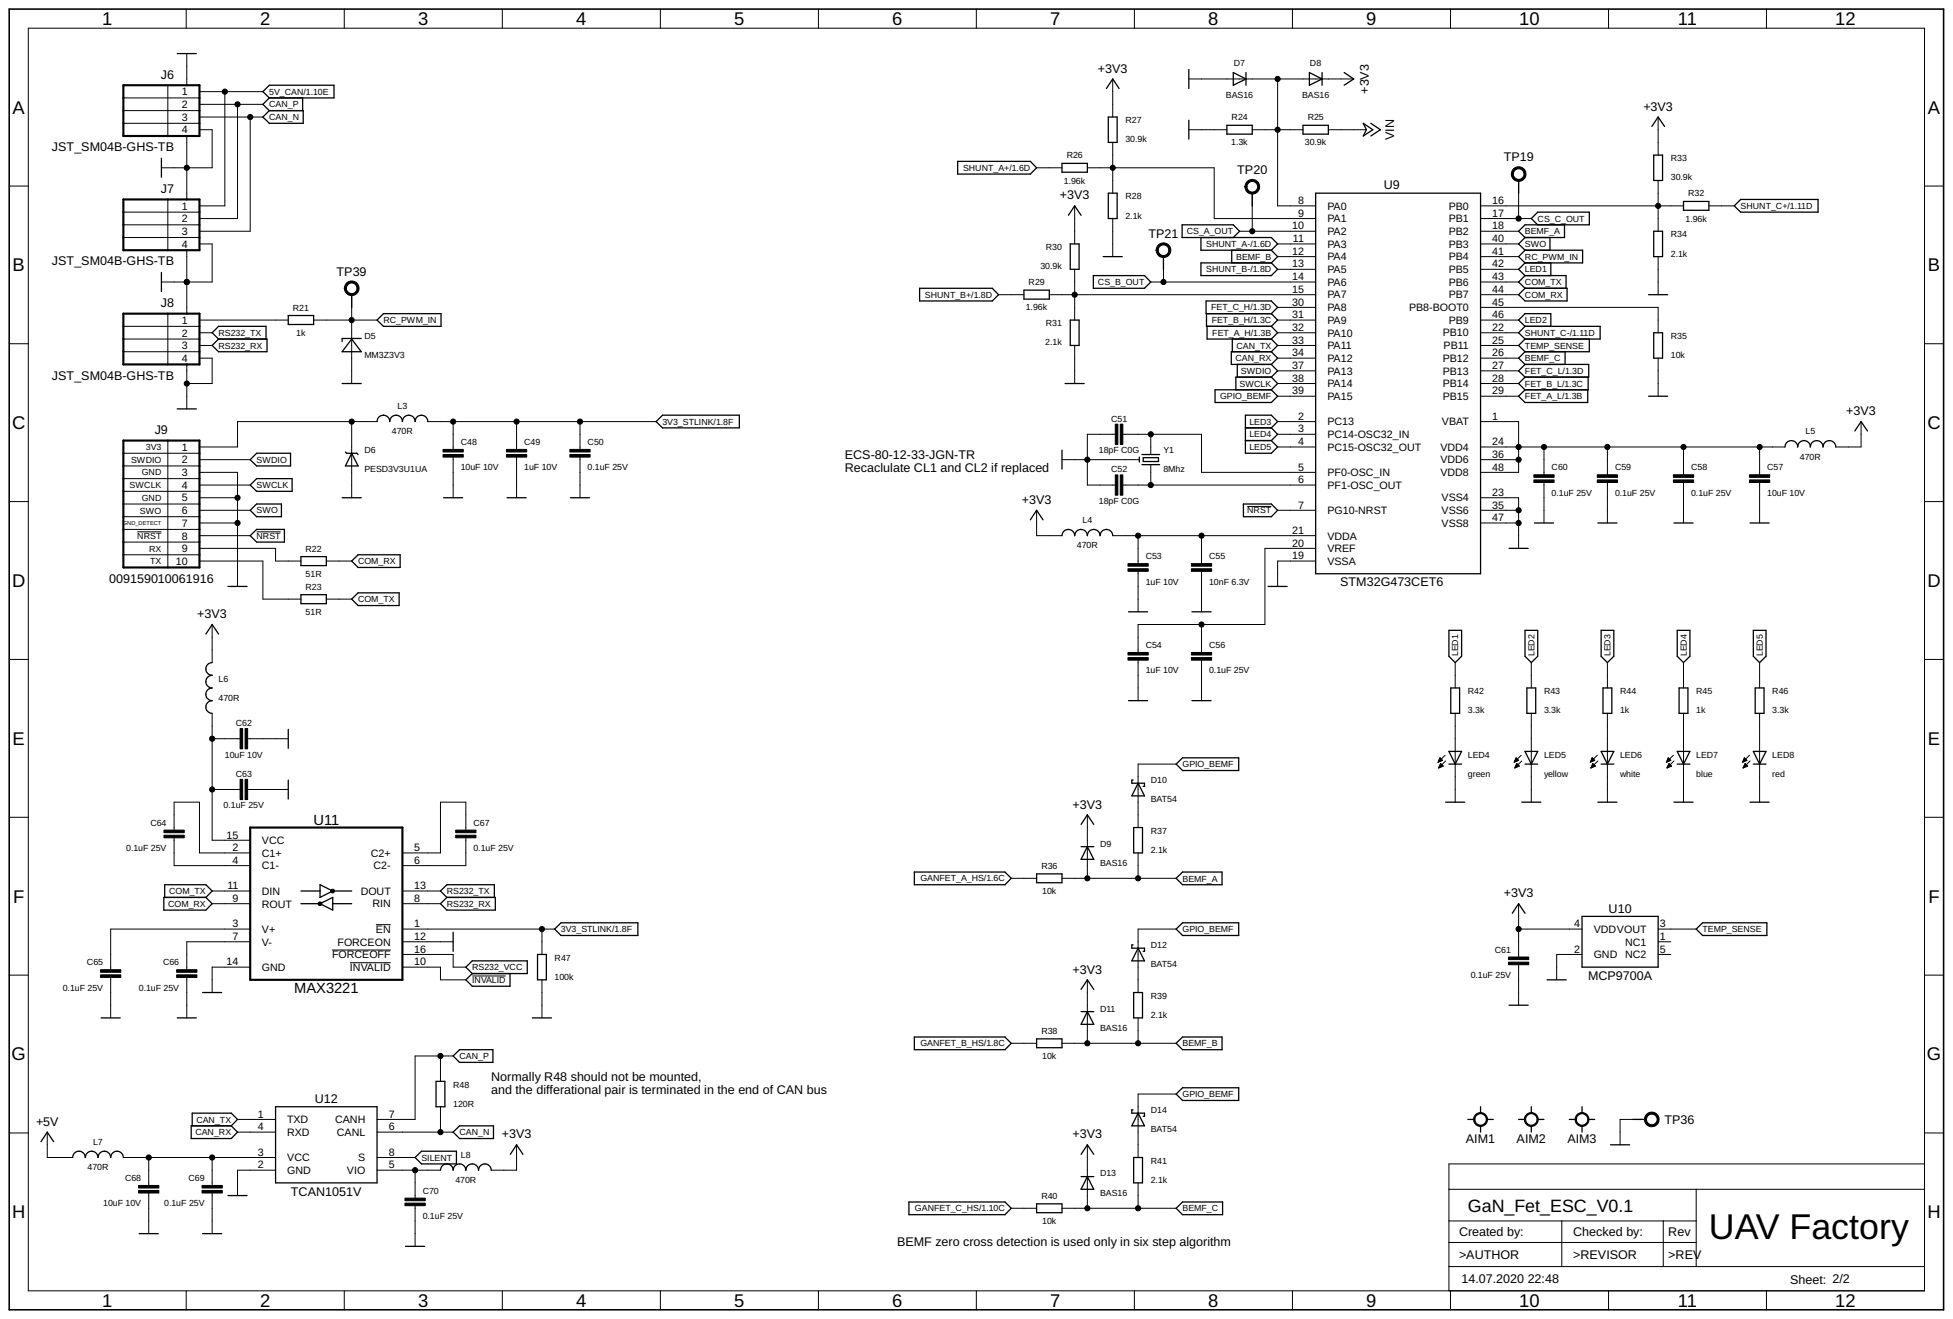
[picture p13: page 2]

3 | CAN_N

ECS-80-12-33-JGN-TR
Recaclulate CL1 and CL2 if replaced

SWCLK | 4 | SWCLK
GND | 5

CAN_P
Normally R48 should not be mounted, and the differational pair is terminated in the end of CAN bus

BEMF zero cross detection is used only in six step algorithm
