depalamarchuk/GaNFET-ESC/ESC_hardware/GaN_Fet_ESC/V0.1/GaN_Fet_ESC_V0.1_Assembly/GaN_Fet_ESC_V0.1_ASSEMBLY_TOP.pdf

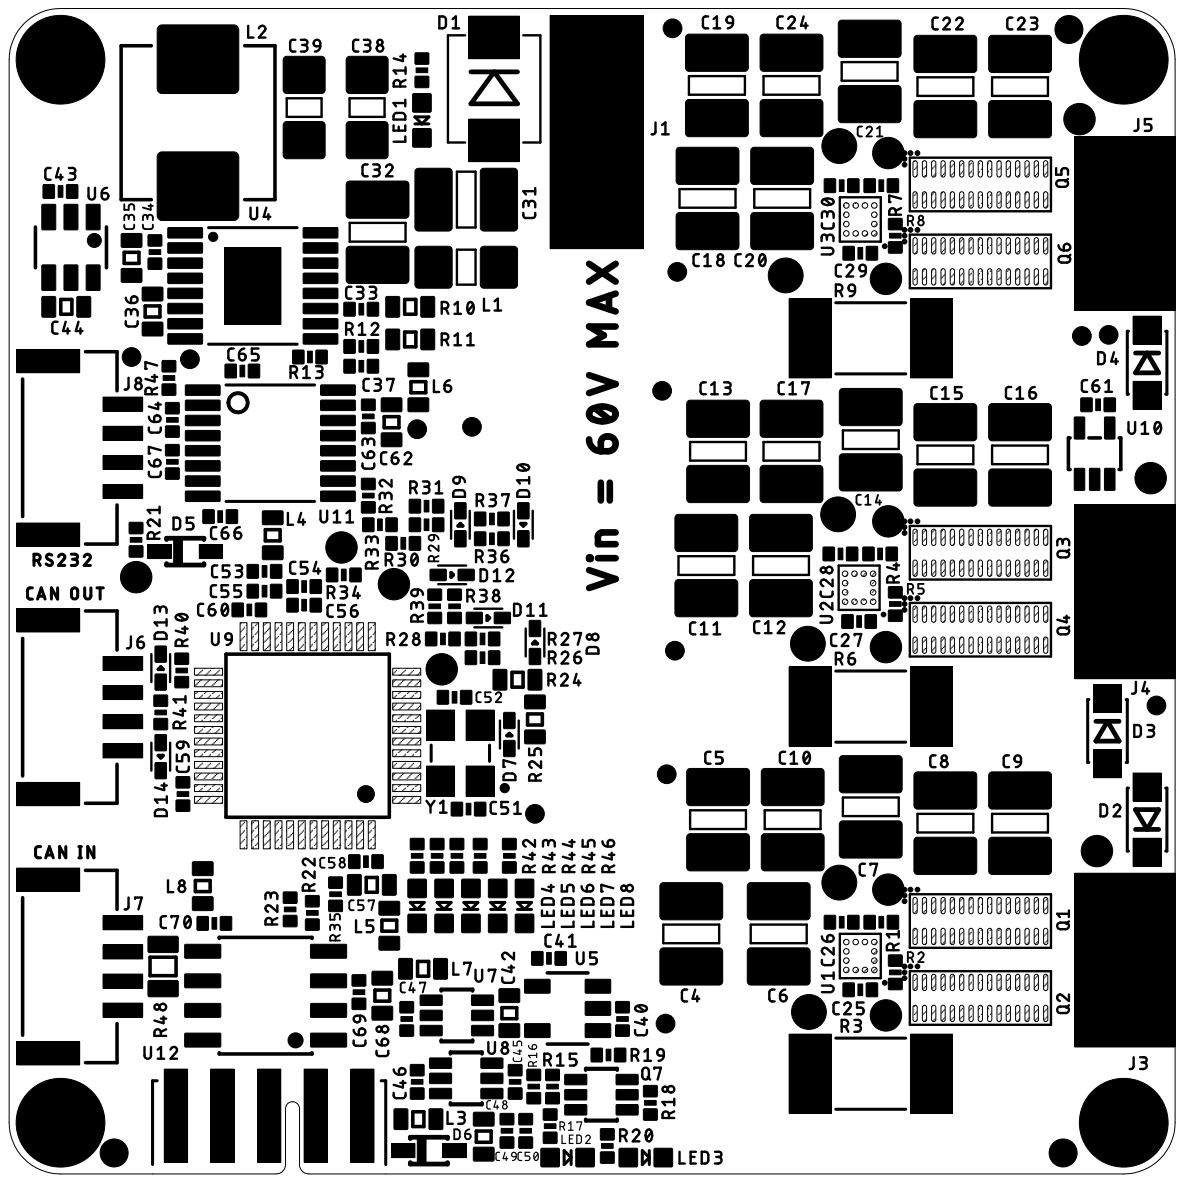
[picture p15: page 1]
