depalamarchuk/GaNFET-ESC/ESC_hardware/GaN_Fet_ESC/V0.1/GaN_Fet_ESC_V0.1_PCB/GaN_Fet_ESC_V0.1.brd

## EAGLE design ESC_hardware/GaN_Fet_ESC/V0.1/GaN_Fet_ESC_V0.1_PCB/GaN_Fet_ESC_V0.1.brd (2020-09-20, an earlier design)

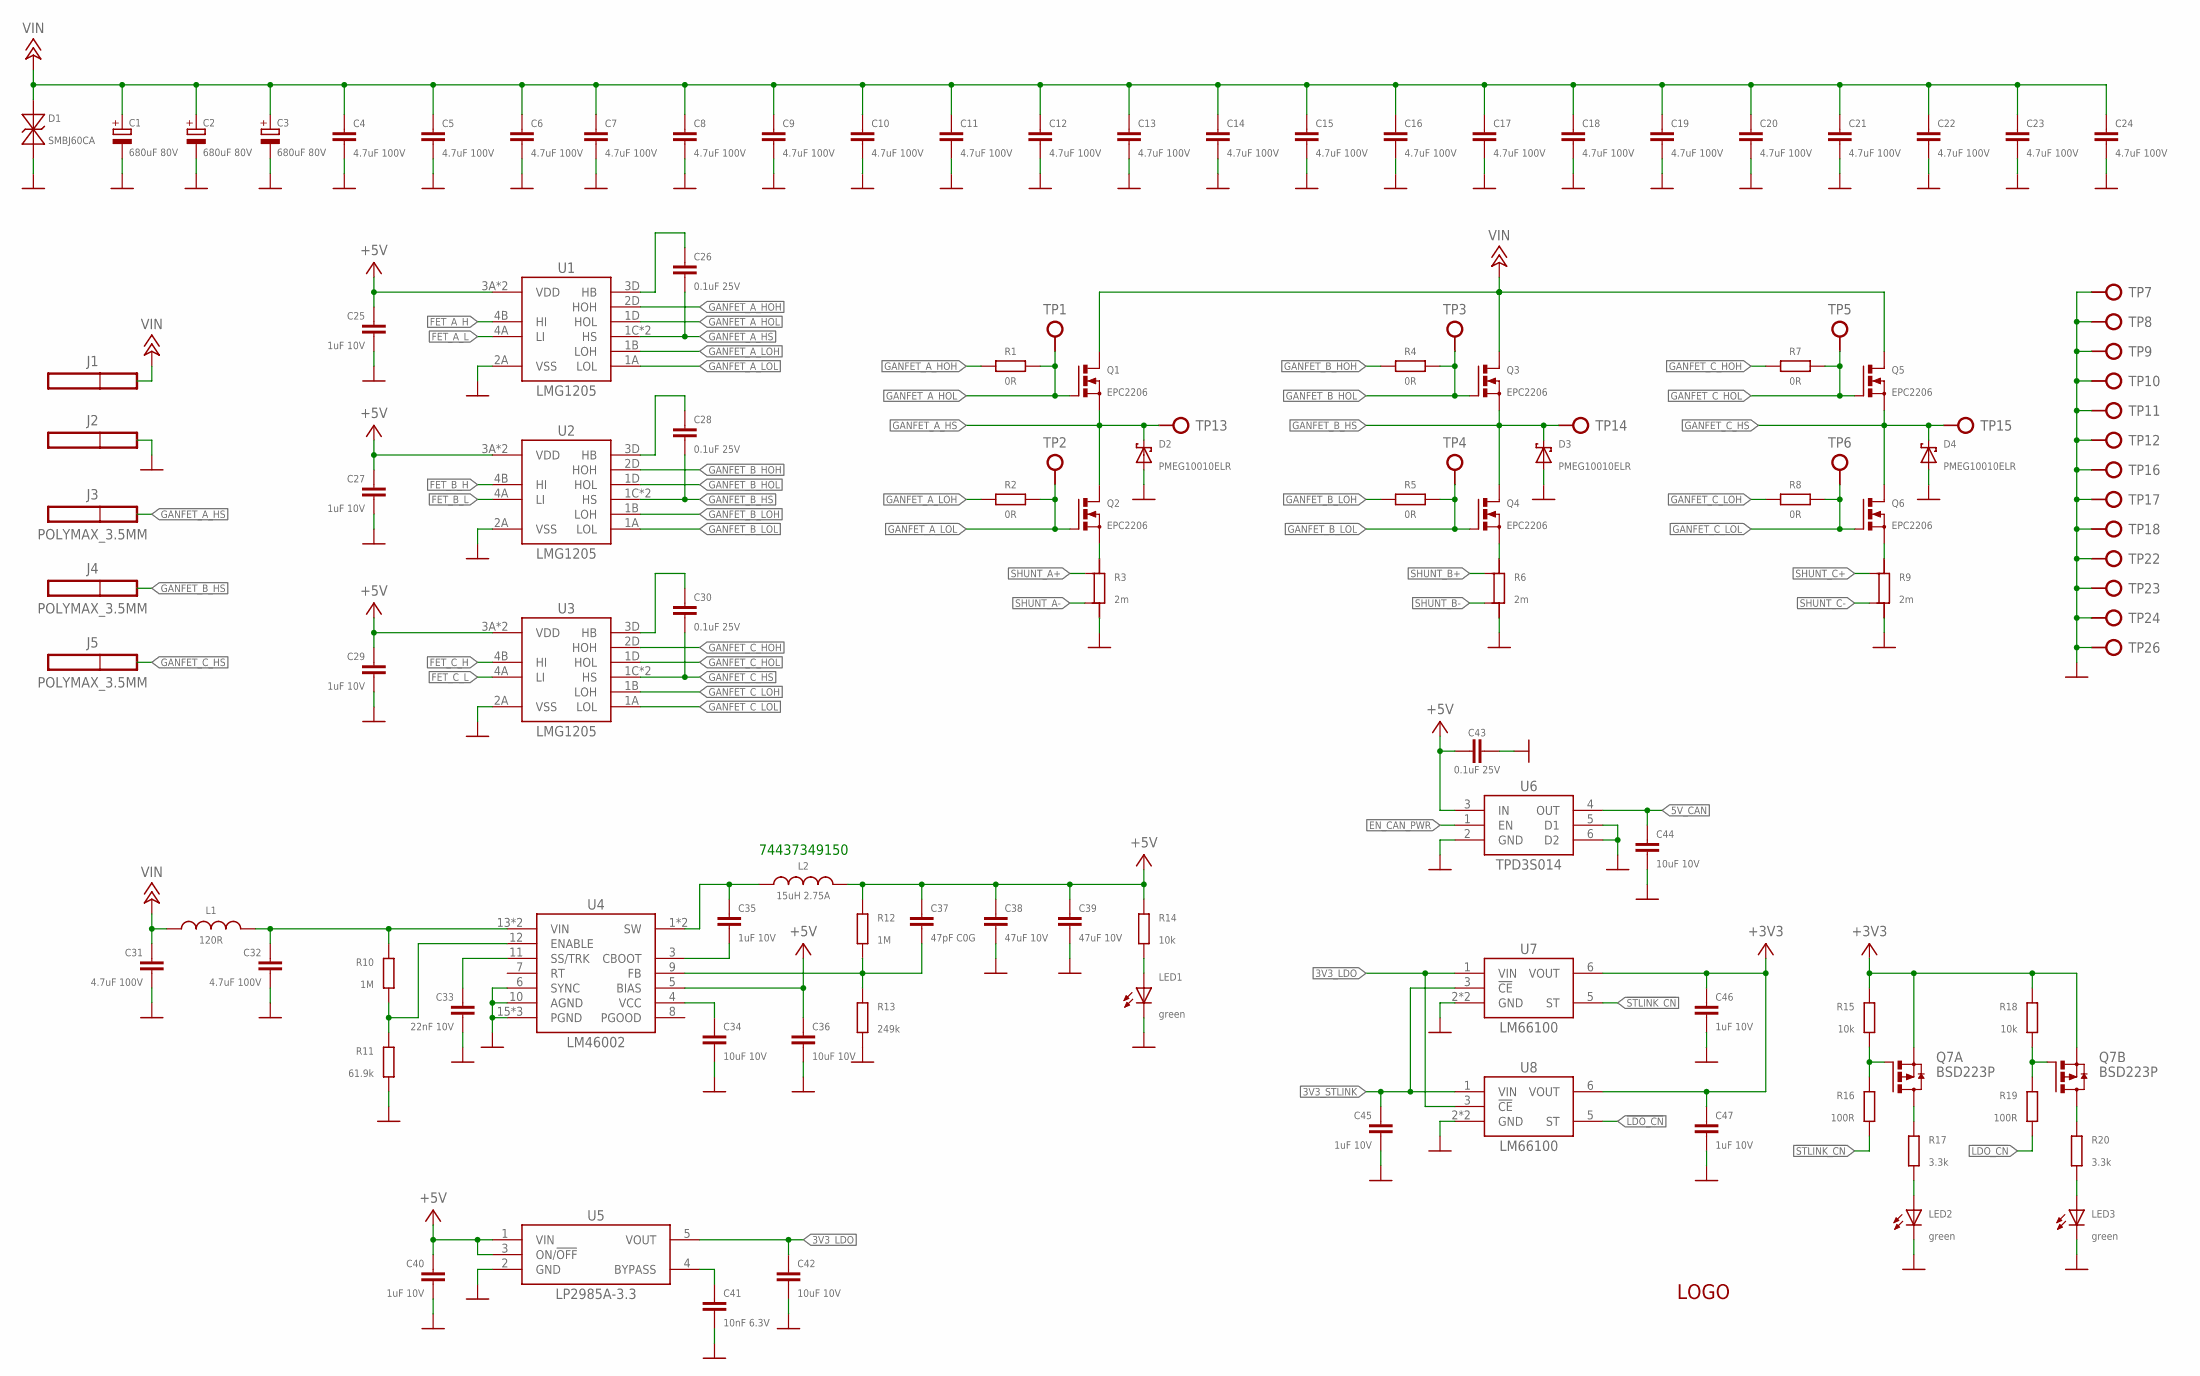
[picture p20: schematic GaN_Fet_ESC_V0.1.sch, sheet 1, Power Stage]

Parts:
C1: 680uF 80V; C_7.50_16_26.5_1
C2: 680uF 80V; C_7.50_16_26.5_2
C3: 680uF 80V; C_7.50_16_26.5_3
C4, C5, C6, C7, C8, C9, C10, C11, C12, C13, C14, C15, C16, C17, C18, C19, C20, C21, C22, C23, C24, C31, C32: 4.7uF 100V; C1210
C25, C27, C29, C35, C40, C45, C46, C47: 1uF 10V; C0402
C26, C28, C30, C43: 0.1uF 25V; C0402
C33: 22nF 10V; C0402
C34, C36, C42, C44: 10uF 10V; C0603
C37: 47pF C0G; C0402
C38, C39: 47uF 10V; C1206
C41: 10nF 6.3V; C0402
D1: SMBJ60CA; DO214AA(SMB)
D2, D3, D4: PMEG10010ELR; SOD123F
J1, J2: PIN_14X10; 4X10SMD
J3, J4, J5: POLYMAX_3.5MM
L1: 120R; L1206
L2: 15uH 2.75A; WURTH_6.6X6.6
LED1, LED2, LED3: green; CHIP-LED0603
Q1, Q2, Q3, Q4, Q5, Q6: EPC2206
Q7: BSD223P; SC-70-6
R1, R2, R4, R5, R7, R8: 0R; R0402
R3, R6, R9: 2m; CSS2H-2512
R10: 1M; R0603
R11: 61.9k; R0603
R12: 1M; R0402
R13: 249k; R0402
R14, R15, R18: 10k; R0402
R16, R19: 100R; R0402
R17, R20: 3.3k; R0402
TP1, TP2, TP3, TP4, TP5, TP6, TP13, TP14, TP15: TESTPOINT/0.9MM; 0.9MM
TP7, TP8, TP9, TP10, TP11, TP12, TP16, TP17, TP18, TP22, TP23, TP24, TP26: TESTPOINT0.5MM; 0.5MM
U1, U2, U3: LMG1205
U4: LM46002; TSS0P16-PAD
U5: LP2985A-3.3; SOT-23-5
U6: TPD3S014; SOT-23-6
U7, U8: LM66100; SC-70-6
U$1: LOGO

Connections:
3V3_LDO: C42.1, U5.5 (VOUT), U7.1 (VIN), U8.3 (!CE)
3V3_STLINK: C45.1, U7.3 (!CE), U8.1 (VIN); also elsewhere on the board
5V_CAN: C44.1, U6.4 (OUT); also elsewhere on the board
5V_VCC: C34.1, U4.4 (VCC)
5V_VIN: C32.1, L1.2, R10.2, U4.13 (VIN), U4.14 (VIN)
!LDO_CN: R19.1, U8.5 (ST)
!STLINK_CN: R16.1, U7.5 (ST)
+3V3: C46.1, C47.1, Q7.1 (S), Q7.4 (S), R15.2, R18.2, U7.6 (VOUT), U8.6 (VOUT); also elsewhere on the board
+5V: C25.1, C27.1, C29.1, C36.1, C37.1, C38.1, C39.1, C40.1, C43.1, L2.2, R12.2, R14.2, U1.3A (VDD), U1.4C (VDD), U2.3A (VDD), U2.4C (VDD), U3.3A (VDD), U3.4C (VDD), U4.5 (BIAS), U5.1 (VIN), U5.3 (ON/!OFF), U6.3 (IN); also elsewhere on the board
CBOOT: C35.2, U4.3 (CBOOT)
ENABLE: R10.1, R11.2, U4.12 (ENABLE)
EN_CAN_PWR: U6.1 (EN)
FB: C37.2, R12.1, R13.2, U4.9 (FB)
FET_A_H: U1.4B (HI); also elsewhere on the board
FET_A_L: U1.4A (LI); also elsewhere on the board
FET_B_H: U2.4B (HI); also elsewhere on the board
FET_B_L: U2.4A (LI); also elsewhere on the board
FET_C_H: U3.4B (HI); also elsewhere on the board
FET_C_L: U3.4A (LI); also elsewhere on the board
GANFET_A_HB: C26.1, U1.3D (HB)
GANFET_A_HOH: R1.1, U1.2D (HOH)
GANFET_A_HOL: Q1.1 (G), R1.2, TP1.P$1, U1.1D (HOL)
GANFET_A_HS: C26.2, D2.C, J3.1, Q1.2 (S), Q1.5 (S), Q1.6 (S), Q1.9 (S), Q1.10 (S), Q1.13 (S), Q1.14 (S), Q1.17 (S), Q1.18 (S), Q1.21 (S), Q1.22 (S), Q1.25 (S), Q1.26 (S), Q1.29 (S), Q1.30 (S), Q2.3 (D), Q2.4 (D), Q2.7 (D), Q2.8 (D), Q2.11 (D), Q2.12 (D), Q2.15 (D), Q2.16 (D), Q2.19 (D), Q2.20 (D), Q2.23 (D), Q2.24 (D), Q2.27 (D), Q2.28 (D), TP13.P$1, U1.1C (HS), U1.4D (HS); also elsewhere on the board
GANFET_A_LOH: R2.1, U1.1B (LOH)
GANFET_A_LOL: Q2.1 (G), R2.2, TP2.P$1, U1.1A (LOL)
GANFET_A_SHUNT: Q2.2 (S), Q2.5 (S), Q2.6 (S), Q2.9 (S), Q2.10 (S), Q2.13 (S), Q2.14 (S), Q2.17 (S), Q2.18 (S), Q2.21 (S), Q2.22 (S), Q2.25 (S), Q2.26 (S), Q2.29 (S), Q2.30 (S), R3.1
GANFET_B_HB: C28.1, U2.3D (HB)
GANFET_B_HOH: R4.1, U2.2D (HOH)
GANFET_B_HOL: Q3.1 (G), R4.2, TP3.P$1, U2.1D (HOL)
GANFET_B_HS: C28.2, D3.C, J4.1, Q3.2 (S), Q3.5 (S), Q3.6 (S), Q3.9 (S), Q3.10 (S), Q3.13 (S), Q3.14 (S), Q3.17 (S), Q3.18 (S), Q3.21 (S), Q3.22 (S), Q3.25 (S), Q3.26 (S), Q3.29 (S), Q3.30 (S), Q4.3 (D), Q4.4 (D), Q4.7 (D), Q4.8 (D), Q4.11 (D), Q4.12 (D), Q4.15 (D), Q4.16 (D), Q4.19 (D), Q4.20 (D), Q4.23 (D), Q4.24 (D), Q4.27 (D), Q4.28 (D), TP14.P$1, U2.1C (HS), U2.4D (HS); also elsewhere on the board
GANFET_B_LOH: R5.1, U2.1B (LOH)
GANFET_B_LOL: Q4.1 (G), R5.2, TP4.P$1, U2.1A (LOL)
GANFET_B_SHUNT: Q4.2 (S), Q4.5 (S), Q4.6 (S), Q4.9 (S), Q4.10 (S), Q4.13 (S), Q4.14 (S), Q4.17 (S), Q4.18 (S), Q4.21 (S), Q4.22 (S), Q4.25 (S), Q4.26 (S), Q4.29 (S), Q4.30 (S), R6.1
GANFET_C_HB: C30.1, U3.3D (HB)
GANFET_C_HOH: R7.1, U3.2D (HOH)
GANFET_C_HOL: Q5.1 (G), R7.2, TP5.P$1, U3.1D (HOL)
GANFET_C_HS: C30.2, D4.C, J5.1, Q5.2 (S), Q5.5 (S), Q5.6 (S), Q5.9 (S), Q5.10 (S), Q5.13 (S), Q5.14 (S), Q5.17 (S), Q5.18 (S), Q5.21 (S), Q5.22 (S), Q5.25 (S), Q5.26 (S), Q5.29 (S), Q5.30 (S), Q6.3 (D), Q6.4 (D), Q6.7 (D), Q6.8 (D), Q6.11 (D), Q6.12 (D), Q6.15 (D), Q6.16 (D), Q6.19 (D), Q6.20 (D), Q6.23 (D), Q6.24 (D), Q6.27 (D), Q6.28 (D), TP15.P$1, U3.1C (HS), U3.4D (HS); also elsewhere on the board
GANFET_C_LOH: R8.1, U3.1B (LOH)
GANFET_C_LOL: Q6.1 (G), R8.2, TP6.P$1, U3.1A (LOL)
GANFET_C_SHUNT: Q6.2 (S), Q6.5 (S), Q6.6 (S), Q6.9 (S), Q6.10 (S), Q6.13 (S), Q6.14 (S), Q6.17 (S), Q6.18 (S), Q6.21 (S), Q6.22 (S), Q6.25 (S), Q6.26 (S), Q6.29 (S), Q6.30 (S), R9.1
GND: C1.-, C2.-, C3.-, C4.2, C5.2, C6.2, C7.2, C8.2, C9.2, C10.2, C11.2, C12.2, C13.2, C14.2, C15.2, C16.2, C17.2, C18.2, C19.2, C20.2, C21.2, C22.2, C23.2, C24.2, C25.2, C27.2, C29.2, C31.2, C32.2, C33.2, C34.2, C36.2, C38.2, C39.2, C40.2, C41.2, C42.2, C43.2, C44.2, C45.2, C46.2, C47.2, D1.K (C), D2.A, D3.A, D4.A, J2.1, LED1.C, LED2.C, LED3.C, R3.2, R6.2, R9.2, R11.1, R13.1, TP7.P$1, TP8.P$1, TP9.P$1, TP10.P$1, TP11.P$1, TP12.P$1, TP16.P$1, TP17.P$1, TP18.P$1, TP22.P$1, TP23.P$1, TP24.P$1, TP26.P$1, U1.2A (VSS), U2.2A (VSS), U3.2A (VSS), U4.6 (SYNC), U4.10 (AGND), U4.15 (PGND), U4.16 (PGND), U4.PAD (PGND), U5.2 (GND), U6.2 (GND), U6.5 (D1), U6.6 (D2), U7.2 (GND), U7.4 (GND), U8.2 (GND), U8.4 (GND); also elsewhere on the board
LDO_BYPASS: C41.1, U5.4 (BYPASS)
unnamed: LED3.A, R20.1
unnamed: LED2.A, R17.1
unnamed: LED1.A, R14.1
unnamed: Q7.3 (D), R17.2
unnamed: Q7.6 (D), R20.2
unnamed: Q7.2 (G), R15.1, R16.2
unnamed: Q7.5 (G), R18.1, R19.2
SHUNT_A+: R3.1_SENSE (1K); also elsewhere on the board
SHUNT_A-: R3.2_SENSE (2K); also elsewhere on the board
SHUNT_B+: R6.1_SENSE (1K); also elsewhere on the board
SHUNT_B-: R6.2_SENSE (2K); also elsewhere on the board
SHUNT_C+: R9.1_SENSE (1K); also elsewhere on the board
SHUNT_C-: R9.2_SENSE (2K); also elsewhere on the board
SS: C33.1, U4.11 (SS/TRK)
SW: C35.1, L2.1, U4.1 (SW), U4.2 (SW)
VIN: C1.+, C2.+, C3.+, C4.1, C5.1, C6.1, C7.1, C8.1, C9.1, C10.1, C11.1, C12.1, C13.1, C14.1, C15.1, C16.1, C17.1, C18.1, C19.1, C20.1, C21.1, C22.1, C23.1, C24.1, C31.1, D1.A, J1.1, L1.1, Q1.3 (D), Q1.4 (D), Q1.7 (D), Q1.8 (D), Q1.11 (D), Q1.12 (D), Q1.15 (D), Q1.16 (D), Q1.19 (D), Q1.20 (D), Q1.23 (D), Q1.24 (D), Q1.27 (D), Q1.28 (D), Q3.3 (D), Q3.4 (D), Q3.7 (D), Q3.8 (D), Q3.11 (D), Q3.12 (D), Q3.15 (D), Q3.16 (D), Q3.19 (D), Q3.20 (D), Q3.23 (D), Q3.24 (D), Q3.27 (D), Q3.28 (D), Q5.3 (D), Q5.4 (D), Q5.7 (D), Q5.8 (D), Q5.11 (D), Q5.12 (D), Q5.15 (D), Q5.16 (D), Q5.19 (D), Q5.20 (D), Q5.23 (D), Q5.24 (D), Q5.27 (D), Q5.28 (D); also elsewhere on the board

Notes on the sheet:
74437349150
