depalamarchuk/GaNFET-ESC/ESC_hardware/GaN_Fet_ESC/V0.1/GaN_Fet_ESC_V0.1_PCB/GaN_Fet_ESC_V0.1.brd

## EAGLE design ESC_hardware/GaN_Fet_ESC/V0.1/GaN_Fet_ESC_V0.1_PCB/GaN_Fet_ESC_V0.1.brd (continued)

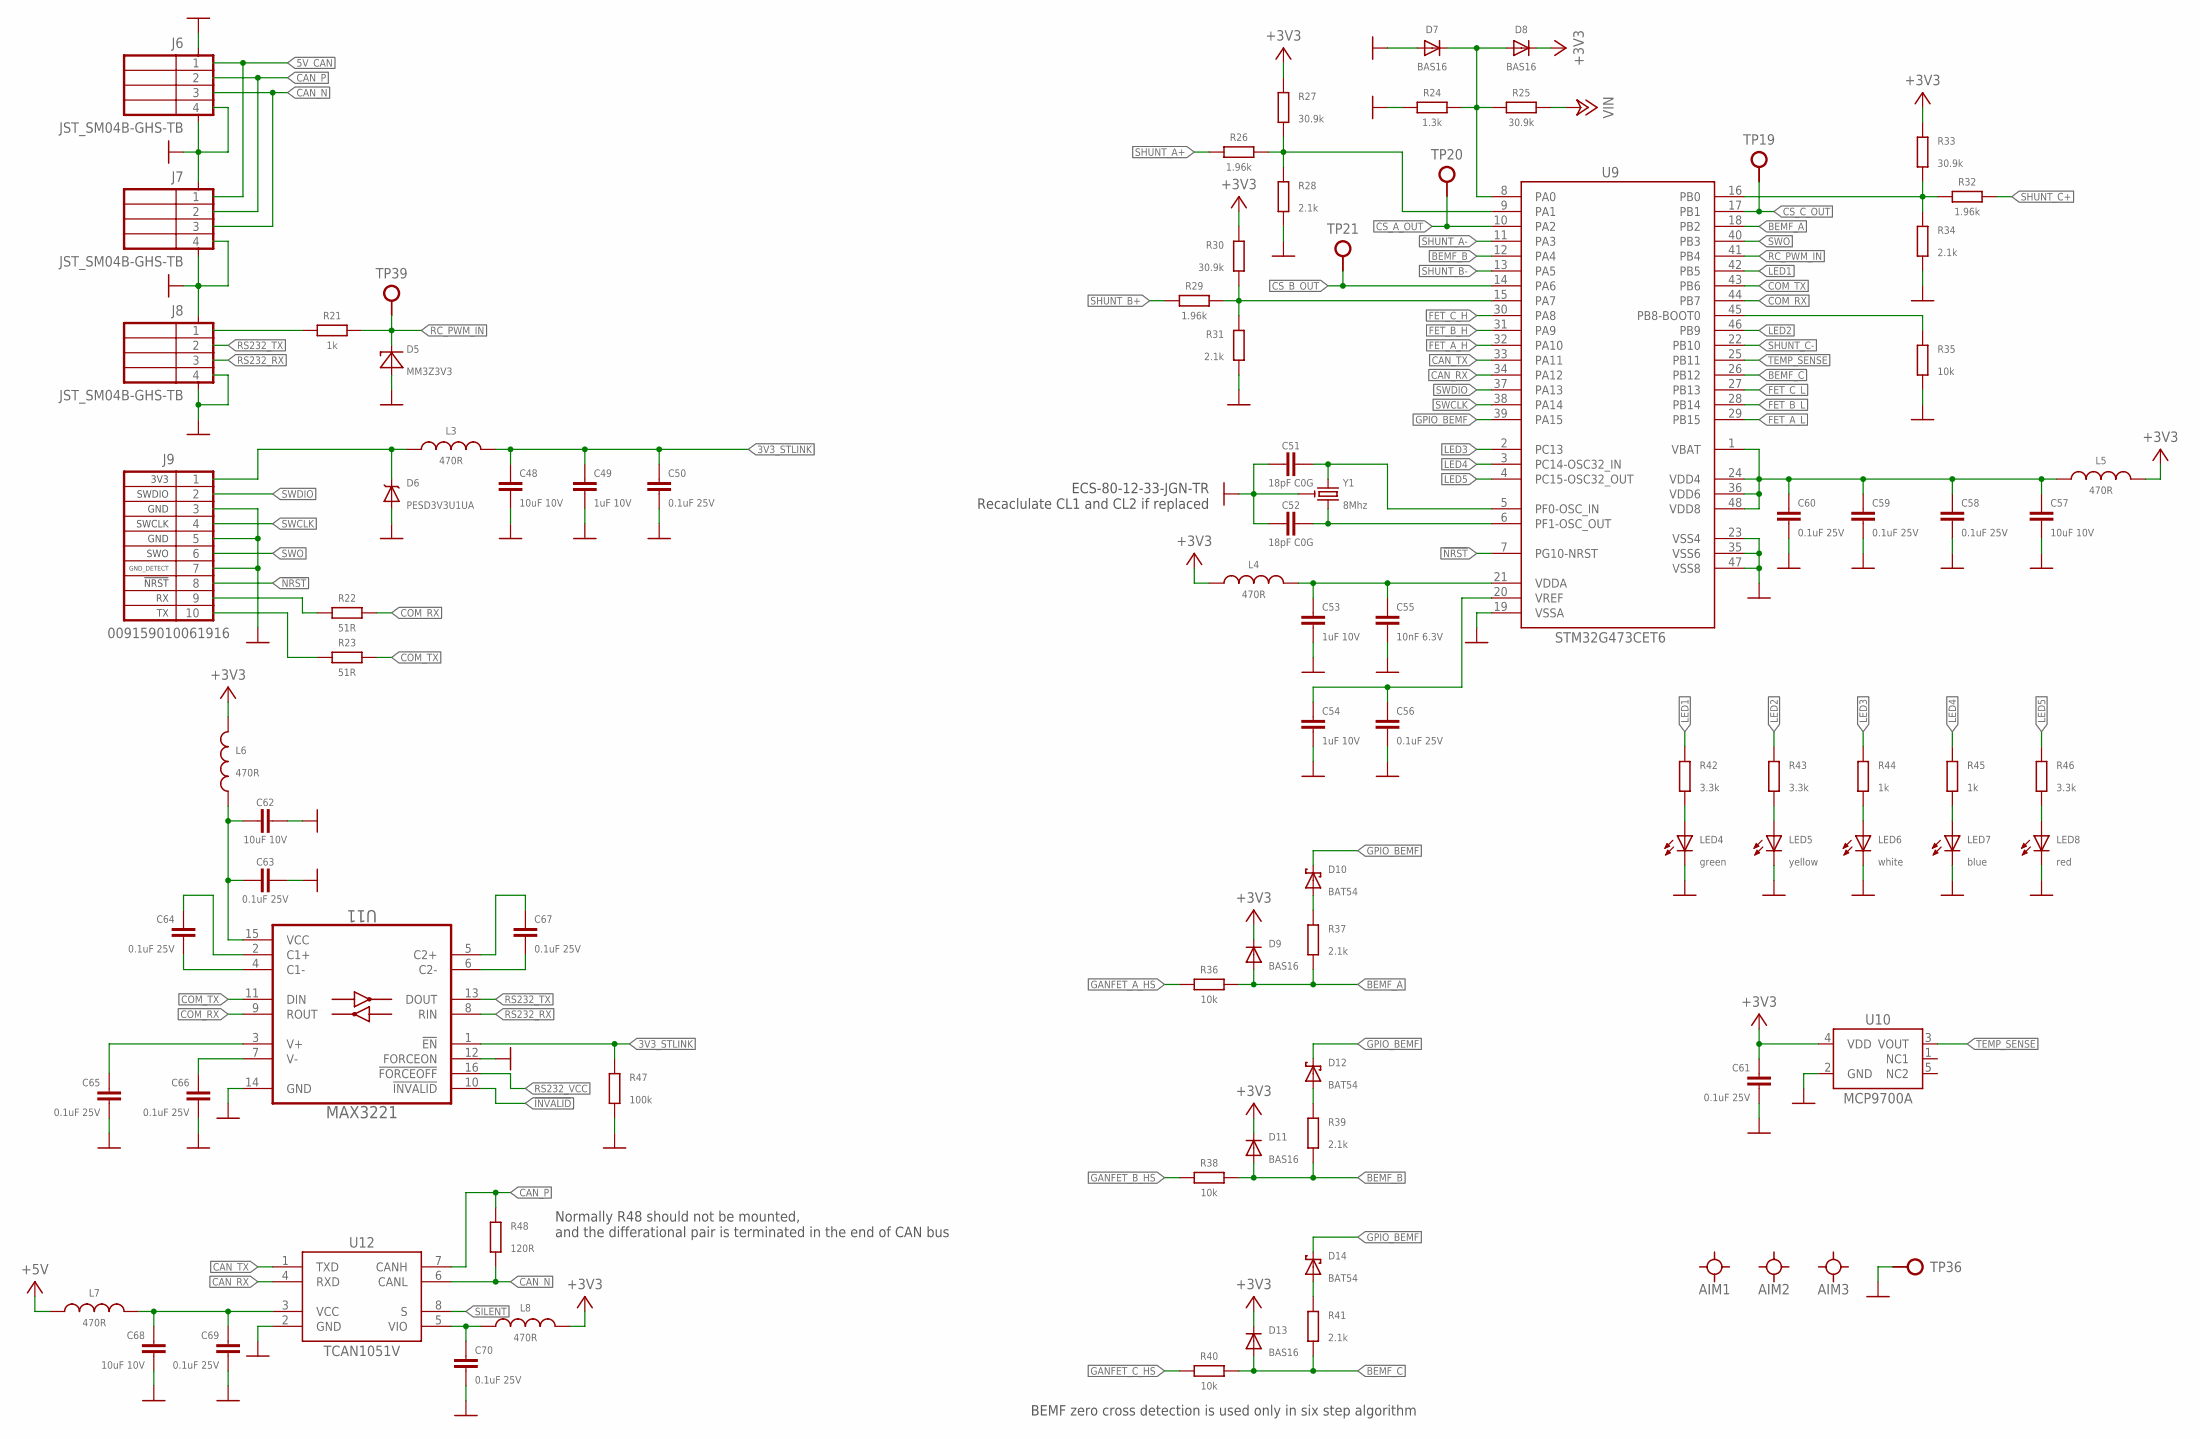
[picture p21: schematic GaN_Fet_ESC_V0.1.sch, sheet 2, Signal Processing]

Parts:
AIM1, AIM2, AIM3: AIM_1_MM
C48, C57, C62, C68: 10uF 10V; C0603
C49, C53, C54: 1uF 10V; C0402
C50, C56, C58, C59, C60, C61, C63, C64, C65, C66, C67, C69, C70: 0.1uF 25V; C0402
C51, C52: 18pF C0G; C0402
C55: 10nF 6.3V; C0402
D5: MM3Z3V3; SOD323F
D6: PESD3V3U1UA; SOD323F
D7, D8, D9, D11, D13: BAS16; SOD523
D10, D12, D14: BAT54; SOD523
J6, J7, J8: JST_SM04B-GHS-TB
J9: 009159010061916
L3, L4, L5, L6, L7, L8: 470R; L0603
LED4: green; CHIP-LED0603
LED5: yellow; CHIP-LED0603
LED6: white; CHIP-LED0603
LED7: blue; CHIP-LED0603
LED8: red; CHIP-LED0603
R21, R44, R45: 1k; R0402
R22, R23: 51R; R0402
R24: 1.3k; R0603
R25: 30.9k; R0603
R26, R29, R32: 1.96k; R0402
R27, R30, R33: 30.9k; R0402
R28, R31, R34, R37, R39, R41: 2.1k; R0402
R35, R36, R38, R40: 10k; R0402
R42, R43, R46: 3.3k; R0402
R47: 100k; R0402
R48: 120R; R0805
TP19, TP20, TP21, TP39: TESTPOINT/0.9MM; 0.9MM
TP36: TESTPOINT0.5MM; 0.5MM
U9: STM32G473CET6; LQFP-48
U10: MCP9700A; SC-70-5
U11: MAX3221; TSS0P16
U12: TCAN1051V; SOIC-8
Y1: 8Mhz; CRYSTAL_SMD_3.2X2.5MM

Connections:
3V3_STLINK: C48.1, C49.1, C50.1, L3.1, R47.2, U11.1 (!EN); also elsewhere on the board
5V_CAN: J6.1, J7.1; also elsewhere on the board
!INVALID: U11.10 (!INVALID)
!NRST: J9.8, U9.7 (PG10-NRST)
+3V3: C61.1, D8.C, D9.C, D11.C, D13.C, L4.1, L5.2, L6.1, L8.2, R27.2, R30.2, R33.2, U10.4 (VDD); also elsewhere on the board
+5V: L7.1; also elsewhere on the board
BEMF_A: D9.A, R36.2, R37.1, U9.18 (PB2)
BEMF_B: D11.A, R38.2, R39.1, U9.12 (PA4)
BEMF_C: D13.A, R40.2, R41.1, U9.26 (PB12)
BOOT0: R35.2, U9.45 (PB8-BOOT0)
C1+: C64.1, U11.2 (C1+)
C1-: C64.2, U11.4 (C1-)
C2+: C67.1, U11.5 (C2+)
C2-: C67.2, U11.6 (C2-)
CAN_N: J6.3, J7.3, R48.1, U12.6 (CANL)
CAN_P: J6.2, J7.2, R48.2, U12.7 (CANH)
CAN_RX: U9.34 (PA12), U12.4 (RXD)
CAN_TX: U9.33 (PA11), U12.1 (TXD)
CAN_VCC: C68.1, C69.1, L7.2, U12.3 (VCC)
CAN_VIO: C70.1, L8.1, U12.5 (VIO)
COM_RX: R22.1, U9.44 (PB7), U11.9 (ROUT)
COM_TX: R23.1, U9.43 (PB6), U11.11 (DIN)
CS_A_OUT: TP20.P$1, U9.10 (PA2)
CS_B_OUT: TP21.P$1, U9.14 (PA6)
CS_C_OUT: TP19.P$1, U9.17 (PB1)
FET_A_H: U9.32 (PA10); also elsewhere on the board
FET_A_L: U9.29 (PB15); also elsewhere on the board
FET_B_H: U9.31 (PA9); also elsewhere on the board
FET_B_L: U9.28 (PB14); also elsewhere on the board
FET_C_H: U9.30 (PA8); also elsewhere on the board
FET_C_L: U9.27 (PB13); also elsewhere on the board
GANFET_A_HS: R36.1; also elsewhere on the board
GANFET_B_HS: R38.1; also elsewhere on the board
GANFET_C_HS: R40.1; also elsewhere on the board
GND: C48.2, C49.2, C50.2, C51.1, C52.1, C53.2, C54.2, C55.2, C56.2, C57.2, C58.2, C59.2, C60.2, C61.2, C62.2, C63.2, C65.2, C66.2, C68.2, C69.2, C70.2, D5.A, D6.A, D7.A, J6.4, J6.5, J6.6, J7.4, J7.5, J7.6, J8.4, J8.5, J8.6, J9.3, J9.5, J9.7, LED4.C, LED5.C, LED6.C, LED7.C, LED8.C, R24.1, R28.1, R31.1, R34.1, R35.1, R47.1, TP36.P$1, U9.19 (VSSA), U9.23 (VSS4), U9.35 (VSS6), U9.47 (VSS8), U10.2 (GND), U11.12 (FORCEON), U11.14 (GND), U12.2 (GND), Y1.2 (3), Y1.4 (3); also elsewhere on the board
GPIO_BEMF: D10.C, D12.C, D14.C, U9.39 (PA15)
LED1: R42.2, U9.42 (PB5)
LED2: R43.2, U9.46 (PB9)
LED3: R44.2, U9.2 (PC13)
LED4: R45.2, U9.3 (PC14-OSC32_IN)
LED5: R46.2, U9.4 (PC15-OSC32_OUT)
MCU_VDD: C57.1, C58.1, C59.1, C60.1, L5.1, U9.1 (VBAT), U9.24 (VDD4), U9.36 (VDD6), U9.48 (VDD8)
MCU_VDDA: C53.1, C55.1, L4.2, U9.21 (VDDA)
MCU_VREF: C54.1, C56.1, U9.20 (VREF)
unnamed: LED5.A, R43.1
unnamed: J9.9, R22.2
unnamed: LED4.A, R42.1
unnamed: LED7.A, R45.1
unnamed: LED8.A, R46.1
unnamed: J8.1, R21.2
unnamed: D12.A, R39.2
unnamed: C51.2, U9.5 (PF0-OSC_IN), Y1.1
unnamed: C52.2, U9.6 (PF1-OSC_OUT), Y1.3 (2)
unnamed: D10.A, R37.2
unnamed: D14.A, R41.2
unnamed: D6.C, J9.1, L3.2
unnamed: J9.10, R23.2
unnamed: LED6.A, R44.1
OPAMP1+: R26.2, R27.1, R28.2, U9.9 (PA1)
OPAMP2+: R29.2, R30.1, R31.2, U9.15 (PA7)
OPAMP3+: R32.2, R33.1, R34.2, U9.16 (PB0)
RC_PWM_IN: D5.C, R21.1, TP39.P$1, U9.41 (PB4)
RS232_RX: J8.3, U11.8 (RIN)
RS232_TX: J8.2, U11.13 (DOUT)
RS232_VCC: C62.1, C63.1, L6.2, U11.15 (VCC), U11.16 (!FORCEOFF)
SHUNT_A+: R26.1; also elsewhere on the board
SHUNT_A-: U9.11 (PA3); also elsewhere on the board
SHUNT_B+: R29.1; also elsewhere on the board
SHUNT_B-: U9.13 (PA5); also elsewhere on the board
SHUNT_C+: R32.1; also elsewhere on the board
SHUNT_C-: U9.22 (PB10); also elsewhere on the board
SILENT: U12.8 (S)
SWCLK: J9.4, U9.38 (PA14)
SWDIO: J9.2, U9.37 (PA13)
SWO: J9.6, U9.40 (PB3)
TEMP_SENSE: U9.25 (PB11), U10.3 (VOUT)
V+: C65.1, U11.3 (V+)
V-: C66.1, U11.7 (V-)
VIN: R25.2; also elsewhere on the board
VIN_SENSE: D7.C, D8.A, R24.2, R25.1, U9.8 (PA0)

Notes on the sheet:
!NRST
GND_DETECT
3V3
SWDIO
SWCLK
SWO
GND
Normally R48 should not be mounted, and the differational pair is terminated in the end of CAN bus
BEMF zero cross detection is used only in six step algorithm
ECS-80-12-33-JGN-TR Recaclulate CL1 and CL2 if replaced

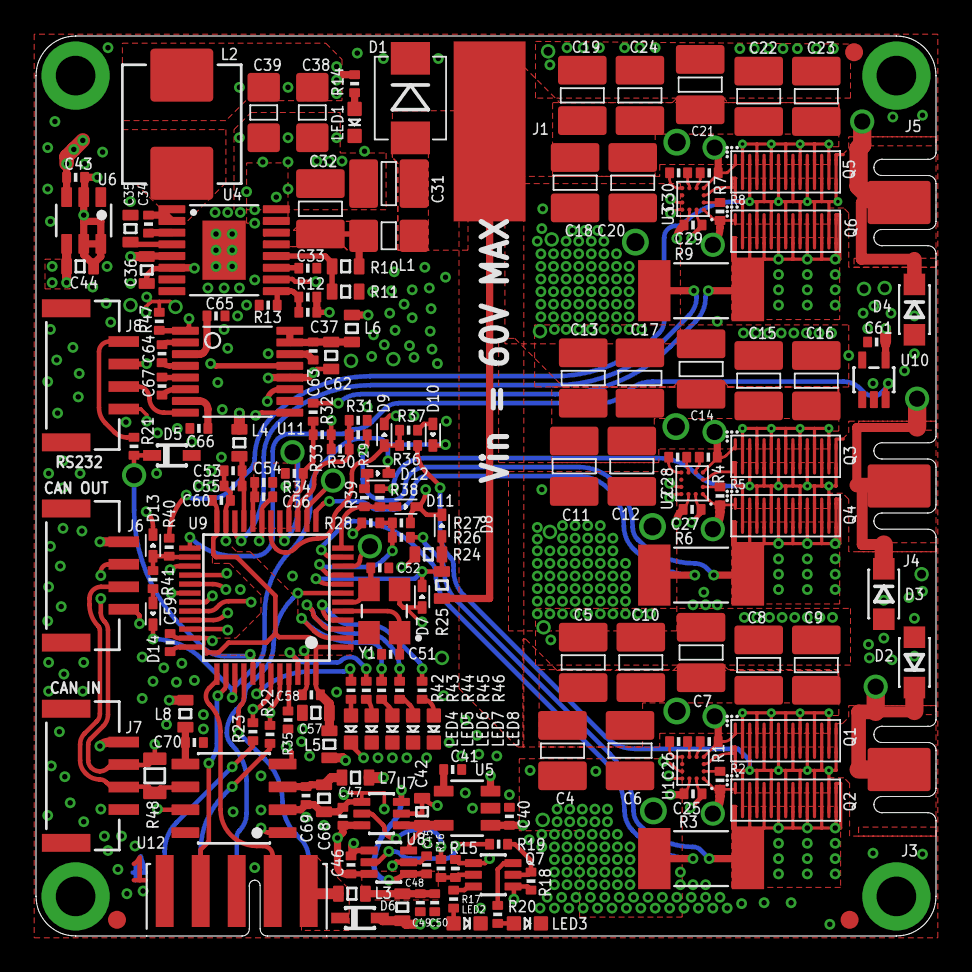
[picture p22: board GaN_Fet_ESC_V0.1.brd from above]

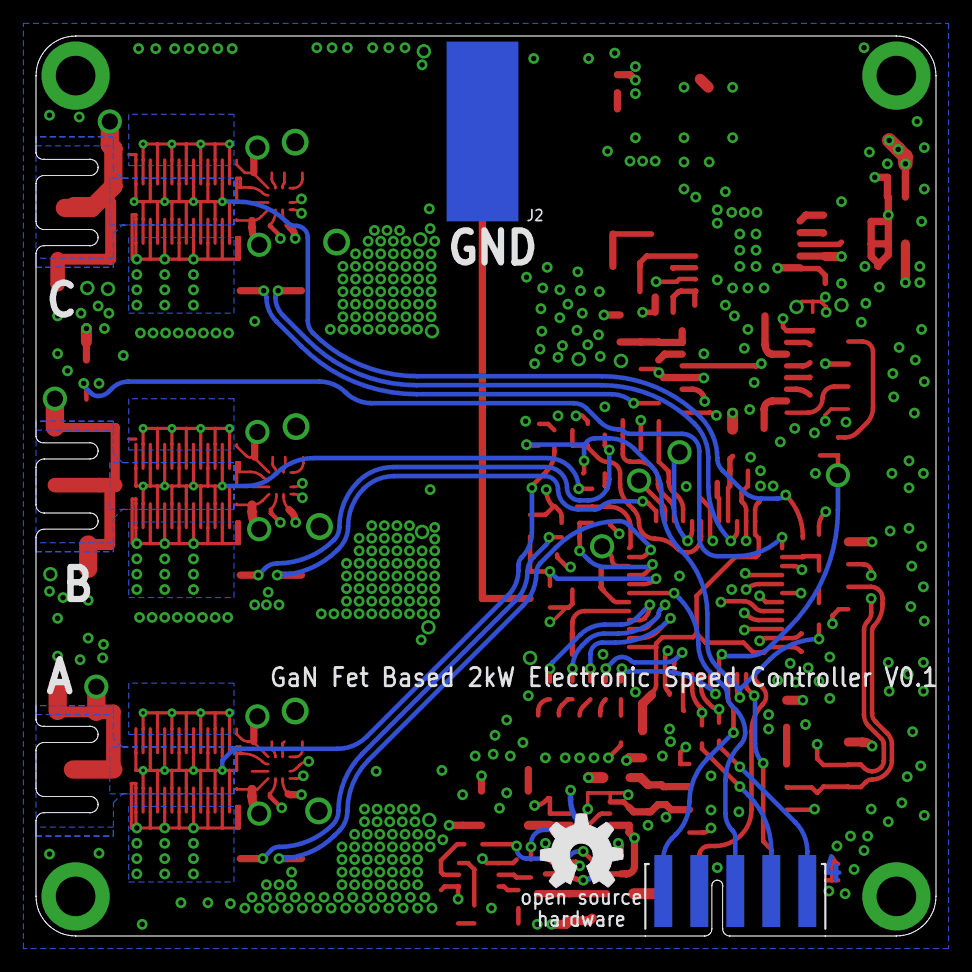
[picture p23: board GaN_Fet_ESC_V0.1.brd from below]

Board: 4 copper layers, 50.0 x 50.0 mm, 208 parts (2 on the bottom side), 114 nets.
