depalamarchuk/GaNFET-ESC/ESC_hardware/GaN_Fet_ESC/V0.2/GaN_Fet_ESC_V0.2_PCB/GaN_Fet_ESC_V0.2.ioc

Mcu.UserName=STM32G473CETx
PA0.Signal=SharedAnalog_PA0
PA1.Signal=SharedAnalog_PA1
PA10.Signal=S_TIM1_CH3
PA11.Signal=FDCAN1_RX
PA12.Signal=FDCAN1_TX
PA13.Signal=SYS_JTMS-SWDIO
PA14.Signal=SYS_JTCK-SWCLK
PA15.Signal=SYS_JTDI
PA2.Signal=ADC1_IN3
PA3.Signal=SharedAnalog_PA3
PA4.Signal=GPIO_Input
PA5.Signal=GPIO_Output
PA6.Signal=ADC2_IN3
PA7.Signal=GPIO_Output
PA8.Signal=S_TIM1_CH1
PA9.Signal=S_TIM1_CH2
PB0.Signal=ADC1_IN15
PB1.Signal=OPAMP3_VOUT
PB10.Signal=GPIO_Output
PB11.Signal=ADC1_IN14
PB12.Signal=ADC4_IN3
PB13.Signal=ADC3_IN5
PB14.Signal=TIM1_CH2N
PB15.Signal=TIM1_CH3N
PB2.Signal=OPAMP3_VINM
PB3.Signal=SYS_JTDO-SWO
PB4.Signal=S_TIM3_CH1
PB5.Signal=GPIO_Output
PB6.Signal=USART1_TX
PB7.Signal=USART1_RX
PB9.Signal=GPIO_Output
PC13.Signal=TIM1_CH1N
PC14-OSC32_IN.Signal=GPXTI14
PC15-OSC32_OUT.Signal=GPXTI15
PF0-OSC_IN.Signal=RCC_OSC_IN
PF1-OSC_OUT.Signal=RCC_OSC_OUT
