depalamarchuk/GaNFET-ESC/ESC_firmware/Main/scr/sysinit.c

/************************************************ Library ************************************************/

#include "sysinit.h"

/********************************************* Used functions ********************************************/

void InitRCC (void){
	uint8_t ticks = 0;													//(1us = 168 ticks @ 168MHz)

	PWR		-> CR1			|= PWR_CR1_VOS_0;							// Ensure range 1
	PWR		-> CR5			&= ~PWR_CR5_R1MODE;							// Range 1 from normal to boost mode

	RCC		->CR			|= ((uint32_t)RCC_CR_HSEON); 				// Enable HSE
	while (!(RCC->CR & RCC_CR_HSERDY));									// Ready to start HSE

	RCC		-> CR			|= RCC_CR_CSSON;

	FLASH	-> ACR			|= FLASH_ACR_PRFTEN;
	FLASH	-> ACR			|= FLASH_ACR_LATENCY_4WS;					// See table 9

	RCC		-> CFGR			|= RCC_CFGR_HPRE_DIV1;						// AHB = SYSCLK/1
	RCC		-> CFGR			|= RCC_CFGR_PPRE1_DIV1;						// APB1 = HCLK/1
	RCC		-> CFGR			|= RCC_CFGR_PPRE2_DIV1;						// APB2 = HCLK/1

	RCC		-> PLLCFGR		&= ~RCC_PLLCFGR_PLLPEN;						// clear PLLPEN bits
	RCC		-> PLLCFGR		&= ~RCC_PLLCFGR_PLLP;						// clear PLLP bits
	RCC		-> PLLCFGR		&= ~RCC_PLLCFGR_PLLQEN;						// clear PLLQEN bits
	RCC		-> PLLCFGR		&= ~RCC_PLLCFGR_PLLQ;						// clear PLLQ bits
	RCC		-> PLLCFGR		&= ~RCC_PLLCFGR_PLLREN;						// clear PLLREN bits
	RCC		-> PLLCFGR		&= ~RCC_PLLCFGR_PLLR;						// clear PLLR bits
	RCC		-> PLLCFGR		&= ~RCC_PLLCFGR_PLLN;						// clear PLLN bits
	RCC		-> PLLCFGR		&= ~RCC_PLLCFGR_PLLM;						// clear PLLM bits
	RCC		-> PLLCFGR		&= ~RCC_PLLCFGR_PLLSRC;               		// clear PLLSRC bits

	RCC		-> PLLCFGR		|= RCC_PLLCFGR_PLLSRC_HSE; 					// source HSE = 8MHz
	RCC		-> PLLCFGR		&= ~RCC_PLLCFGR_PLLM; 					// PLLM = HSE/1 = 8 MHz
	RCC		-> PLLCFGR		|= 0x29UL << RCC_PLLCFGR_PLLN_Pos; 			// PLLN = PLLM*42 = 336 MHz

	RCC		-> PLLCFGR		&= ~RCC_PLLCFGR_PLLR; 						// PLLR = PLLN/2 = 168 MHz
	RCC		-> PLLCFGR		|= RCC_PLLCFGR_PLLREN;

	RCC		-> PLLCFGR		|= RCC_PLLCFGR_PLLSRC; 						//HSE clock selected as PLL clock entry

	RCC		-> PLLCFGR		|= 0x8UL << RCC_PLLCFGR_PLLQ_Pos;			// PLLQ = PLLN/8 = 42 MHz (for FD CAN)
	RCC		-> PLLCFGR		|= RCC_PLLCFGR_PLLQEN;

	RCC		-> PLLCFGR		|= 0x8UL << RCC_PLLCFGR_PLLPDIV_Pos;		// PLLP = PLLN/6 = 56 MHz (for ADC)
	RCC		-> PLLCFGR		|= RCC_PLLCFGR_PLLPEN;

	RCC		-> CR			|= RCC_CR_PLLON;                      		// enable PLL
	while((RCC->CR & RCC_CR_PLLRDY) == 0) {}     						// wait till PLL is ready

	RCC		-> CFGR			&= ~RCC_CFGR_SW;                   			// clear SW bits
	RCC		-> CFGR			|= RCC_CFGR_SW_PLL;               			// select source SYSCLK = PLL
	while((RCC->CFGR & RCC_CFGR_SWS) != RCC_CFGR_SWS) {} 				// wait till PLL is used

	//waiting for at least 1us
	while (!(ticks == 200))
	{
		ticks++;
	}

	ticks = 0;

}

void flashUnlock (void){
	FLASH -> KEYR = INT_FLASH_KEY1;
	FLASH -> KEYR = INT_FLASH_KEY2;
}

void flashLock (void){
	FLASH -> CR |= FLASH_CR_LOCK;
}

void flashAllErase (void){
	FLASH -> CR |= FLASH_CR_MER1;
	FLASH -> CR |= FLASH_CR_STRT;
}

uint32_t flashReadData (uint32_t address){

	return (*(__IO uint32_t*) address);
}

void flashWriteData (uint32_t address, uint32_t data){

	FLASH -> CR |= FLASH_CR_PG;

	while((FLASH -> SR & FLASH_SR_BSY)!=0);

	*(__IO uint16_t*)address = (uint16_t)data;

	while((FLASH -> SR & FLASH_SR_BSY)!=0);

	address+=2;
	data>>=16;

	*(__IO uint16_t*)address = (uint16_t)data;

	while((FLASH -> SR & FLASH_SR_BSY)!=0);

	FLASH -> CR &= ~FLASH_CR_PG;
}


void NMI_Handler(void)
{
	 if (RCC -> CIFR & RCC_CIFR_CSSF)
	 {
		 RCC	->	CICR		|=RCC_CICR_CSSC;						//Clock security system interrupt clear
	 }
}
