depalamarchuk/GaNFET-ESC/ESC_firmware/Analog/inc/adc.h

/************************************************ Library ************************************************/

#include "stm32g4xx.h"

/********************************************* Used functions ********************************************/

void InitADC12 (void);
uint16_t StartConvADC(void);
