depalamarchuk/GaNFET-ESC/FMAC_Demo/Peripheral/inc/vrefbuf.h

/************************************************ Library ************************************************/

#include "stm32g4xx.h"

/********************************************* Used functions ********************************************/

void InitVrefbuf (void);
