depalamarchuk/GaNFET-ESC/(commit log)

2020-11-21 FreeRTOS added, ADC launched.
2020-12-01 Opamp and DMA added
2022-02-13 0.2 hardware version added; some software experiments
    [GaN_Fet_ESC_V0.2.brd, GaN_Fet_ESC_V0.2.sch, GaN_Fet_ESC_V0.2_BOM.xlsx, GaN_Fet_ESC_V0.2_Mouser_order.xlsx, GaN_Fet_ESC_V0.2_What_I_have.xlsx]
